Robert-Kurczak/automated-tip-coater-model/BOM.ods

Sheet: Parts list
Module | Part name | Part type | Notes
base | base-top | External-custom | 260x180mm plane, custom cutout
base | base-left-side | External-custom | 60x180mm plane, custom cutout
base | base-right-side | External-custom | 60x180mm plane, custom cutout
base | v-slot-2060x250mm | External
base | v-slot-2060x250mm | External
base | v-slot-2020x250mm | External
base | v-slot-2020x250mm | External
base | v-slot-l-bracket-triple | External
base | v-slot-l-bracket-triple | External
base | v-slot-l-bracket-triple | External
base | v-slot-l-bracket-triple | External
base | 17hs4023-stepper-motor | External
base | gt2-5mm-16t-belt-gear | External
base | base-bottom | External-custom | 260x180mm plane, custom cutout
heater-module | heater-module-base | 3D Print
heater-module | heater-module-8mm-linear-shaft | External-custom | 72mm length
heater-module | heater-module-8mm-linear-shaft | External-custom | 72mm length
heater-module | heater-module-tray-carriage | 3D Print
heater-module | heater-module-tray-carriage-cap | 3D Print
heater-module | lm8uu-linear-bearing | External
heater-module | lm8uu-linear-bearing | External
heater-module | wk1-01-limit-switch | External
heater-module | wk1-01-limit-switch | External
heater-module | heater-module-tray-cap | 3D Print
heater-module | heater-module-tray-carriage-belt-cap | 3D Print
heater-module | heater-module-lw980-heater-tray | External-custom | CNC
heater-module | ceramic-tape-insert-40x2mm | External
heater-module | lw980-ceramic-heater | External
heater-module | heater-module-mounting | 3D Print
heater-module | gt2-5mm-bearing | External
heater-module | gt2-5mm-bearing | External
rotation-module | rotation-module-mounting | 3D Print
rotation-module | rotation-module-mounting-bracket | 3D Print
rotation-module | pololu-3042-dc-motor | External
rotation-module | bd-microlance-3-26g-needle | External-custom | 7mm needle length
x-axis | x-axis-motor-mounting | 3D Print
x-axis | x-axis-end | 3D Print
x-axis | x-axis-carriage | 3D Print
x-axis | x-axis-carriage-cap | 3D Print
x-axis | lm8uu-linear-bearing | External
x-axis | gt2-5mm-bearing | External
x-axis | lm8uu-linear-bearing | External
x-axis | 17hs4023-stepper-motor | External
x-axis | gt2-5mm-16t-belt-gear | External
x-axis | wk1-01-limit-switch | External
x-axis | wk1-01-limit-switch | External
x-axis | x-axis-8mm-linear-shaft | External-custom | 200mm length
x-axis | x-axis-8mm-linear-shaft | External-custom | 200mm length
z-axis | z-axis-shafts-mounting | 3D Print
z-axis | 17hs8401-stepper-motor | External
z-axis | z-axis-8mm-linear-shaft | External-custom | 197mm length
z-axis | z-axis-8mm-linear-shaft | External-custom | 197mm length
z-axis | 5x8mm-flexible-coupler | External
z-axis | z-axis-tr8x2-lead-screw | External-custom | 113mm length
z-axis | lm8uu-45mm-linear-bearing | External
z-axis | lm8uu-45mm-linear-bearing | External
z-axis | z-axis-carriage | 3D Print
z-axis | z-axis-carriage-bearing-cap | 3D Print
z-axis | z-axis-carriage-bearing-cap | 3D Print

Sheet: External
Part name | Notes | Amount | Link | Price per item [PLN] | Price [PLN] | Total price [PLN]
v-slot-2060x250mm |  | 2 | v-slot.pl (https://www.v-slot.pl/pl/p/V-SLOT-2060-Czarny-Anodowany-250mm/54) | 20.00 | 40.00 | 431.28
v-slot-2020x250mm |  | 2 | v-slot.pl (https://www.v-slot.pl/pl/p/Profil-aluminiowy-konstrukcyjny-V-Slot-2020-Na-wymiar-BLACK/906) | 12.00 | 24.00
v-slot-l-bracket-triple |  | 4 | v-slot.pl (https://www.v-slot.pl/pl/p/Naroznik-typ-L-potrojny-OpenBuilds/224) | 6.99 | 27.96
17hs4023-stepper-motor |  | 2 | allegro.pl-Fotobisti_pl (https://allegro.pl/oferta/silnik-krokowy-nema17-17hs4023-pancake-23mm-118g-16010231320) | 35.85 | 71.70
gt2-5mm-16t-belt-gear |  | 2 | abc-rc.pl (https://abc-rc.pl/pl/products/zebatka-gt2-16-zebow-5mm-drukarka-3d-reprap-3d-cnc-6732.html) | 3.10 | 6.20
lm8uu-linear-bearing |  | 4 | abc-rc.pl (https://abc-rc.pl/pl/products/lozysko-liniowe-lm8uu-8mm-reprap-3d-cnc-6735.html) | 3.00 | 12.00
wk1-01-limit-switch |  | 4 | abc-rc.pl (https://abc-rc.pl/pl/products/wylacznik-krancowy-wk1-01-1a-125v-przelacznik-przyciskowy-20701.html) | 0.90 | 3.60
ceramic-tape-insert-40x2mm |  | 1 | allegro.pl-Bomawit (https://allegro.pl/oferta/tasma-ceramiczna-zaroodporna-1200-c-do-kominka-40x2-mm-5859353940) | 17.60 | 17.60
lw980-ceramic-heater |  | 1 | allegro.pl-GOTRONIK_PL (https://allegro.pl/oferta/grzalka-ceramiczna-do-lw-980d-lut-036-7519979241) | 26.56 | 26.56
gt2-5mm-bearing |  | 3 | abc-rc.pl (https://abc-rc.pl/pl/products/kolo-pasowe-gt2-bez-zebow-czarne-os-5mm-na-pasek-6mm-drukarka-3d-reprap-3d-cnc-20537.html) | 6.20 | 18.60
pololu-3042-dc-motor |  | 1 | ebmia.pl (https://www.ebmia.pl/silniki-dc-z-przekladnia/217056-silnik-hpcb-150-1-12v-200rpm-zamiennik-pololu-3042.html) | 35.60 | 35.60
17hs8401-stepper-motor |  | 1 | allegro.pl-100hz_pl (https://allegro.pl/oferta/silnik-krokowy-do-drukarki-17hs8401-kabel-15601388050) | 48.50 | 48.50
5x8mm-flexible-coupler |  | 1 | abc-rc.pl (https://abc-rc.pl/pl/products/sprzeglo-elastyczne-5-8-mm-sprzeglo-aluminiowe-do-drukarki-3d-6460.html) | 5.80 | 5.80
lm8uu-45mm-linear-bearing |  | 2 | abc-rc.pl (https://abc-rc.pl/pl/products/lozysko-liniowe-lm8uu-8mm-45mm-dl-reprap-3d-cnc-9713.html) | 8.40 | 16.80
Custom parts | #N/A | 0 |  |  | 0.00
heater-module-8mm-linear-shaft | 72mm length | 2 | v-slot.pl (https://www.v-slot.pl/walek-liniowy-prowadnica-fi-8mm) | 35.00 | 35.00
x-axis-8mm-linear-shaft | 200mm length | 2
z-axis-8mm-linear-shaft | 197mm length | 2
base-top | 260x180mm plane, custom cutout | 1 | allegro.pl-Betulla_com_pl (https://allegro.pl/oferta/sklejka-5mm-formatka-600x400mm-klasa-2-do-lasera-8141591806) | 15.20 | 15.20
base-left-side | 60x180mm plane, custom cutout | 1
base-right-side | 60x180mm plane, custom cutout | 1
base-bottom | 260x180mm plane, custom cutout | 1
heater-module-lw980-heater-tray | CNC | 1
bd-microlance-3-26g-needle | 7mm needle length | 1 | medimall.pl (https://medimall.pl/Igly-iniekcyjne-BD-MICROLANCE-045x13-26G-303800-100-sz) | 0.11 | 0.11
z-axis-tr8x2-lead-screw | 113mm length | 1 | allegro.pl-wizjerMP (https://allegro.pl/oferta/sruba-trapezowa-tr8x2-300mm-nakretka-16298195628) | 26.05 | 26.05

Sheet: Parts
Name | Type | Notes | Quantity | Purchase link | Purchase price [PLN] | Purchase quantity | Total price [PLN]
heater-module-base | 3D Print |  | 1 | allegro-sklep_X3D (https://allegro.pl/oferta/filament-fiberlogy-easy-pla-alien-green-zielony-brokatowy-1-75-0-85kg-14364995352) | 88.40 | 1 | 88.40
heater-module-cap | 3D Print |  | 1 | allegro-sklep_X3D (https://allegro.pl/oferta/filament-fiberlogy-easy-pla-black-czarny-1-75mm-0-85kg-10711424223) | 79.10 | 1 | 79.10
heater-module-mounting | 3D Print |  | 1 |  |  |  | 0.00
heater-module-tray-cap | 3D Print |  | 1 |  |  |  | 0.00
heater-module-tray-carriage | 3D Print |  | 1 |  |  |  | 0.00
heater-module-tray-carriage-belt-cap | 3D Print |  | 1 |  |  |  | 0.00
heater-module-tray-carriage-cap | 3D Print |  | 1 |  |  |  | 0.00
rotation-module-mounting | 3D Print |  | 1 |  |  |  | 0.00
rotation-module-mounting-bracket | 3D Print |  | 1 |  |  |  | 0.00
x-axis-carriage | 3D Print |  | 1 |  |  |  | 0.00
x-axis-carriage-cap | 3D Print |  | 1 |  |  |  | 0.00
x-axis-end | 3D Print |  | 1 |  |  |  | 0.00
x-axis-motor-mounting | 3D Print |  | 1 |  |  |  | 0.00
z-axis-carriage | 3D Print |  | 1 |  |  |  | 0.00
z-axis-carriage-bearing-cap | 3D Print |  | 2 |  |  |  | 0.00
z-axis-shafts-mounting | 3D Print |  | 1 |  |  |  | 0.00
10x2mm-magnet | External |  | 4 | abc-rc.pl (https://abc-rc.pl/pl/products/magnes-10x2mm-walcowy-n38-neodymowy-6778.html) | 1.20 | 4 | 4.80
17hs4023-stepper-motor | External |  | 2 | allegro.pl-Fotobisti_pl (https://allegro.pl/oferta/silnik-krokowy-nema17-17hs4023-pancake-23mm-118g-16010231320) | 35.85 | 2 | 71.70
17hs8401-stepper-motor | External |  | 1 | allegro.pl-100hz_pl (https://allegro.pl/oferta/silnik-krokowy-do-drukarki-17hs8401-kabel-15601388050) | 48.50 | 1 | 48.50
5x8mm-flexible-coupler | External |  | 1 | abc-rc.pl (https://abc-rc.pl/pl/products/sprzeglo-elastyczne-5-8-mm-sprzeglo-aluminiowe-do-drukarki-3d-6460.html) | 5.80 | 1 | 5.80
bd-microlance-3-26g-needle | External | 7mm needle length | 1 | medimall.pl (https://medimall.pl/Igly-iniekcyjne-BD-MICROLANCE-045x13-26G-303800-100-sz) | 10.85 | 1 | 10.85
ceramic-tape-insert-40x2mm | External |  | 1 | allegro.pl-Bomawit (https://allegro.pl/oferta/tasma-ceramiczna-zaroodporna-1200-c-do-kominka-40x2-mm-5859353940) | 17.60 | 1 | 17.60
gt2-20t-5mm-driver-pulley | External |  | 2 | abc-rc.pl (https://abc-rc.pl/pl/products/zebatka-gt2-20-zebow-5mm-drukarka-3d-reprap-3d-cnc-6731.html) | 3.60 | 2 | 7.20
gt2-20t-5mm-idle-pulley | External |  | 3 | abc-rc.pl (https://abc-rc.pl/pl/products/zebatka-gt2-20-zebow-os-5mm-na-pasek-6mm-drukarka-3d-reprap-3d-cnc-9740.html) | 5.90 | 3 | 17.70
gt2-brass-clip | External |  | 4 | allegro-4Makers_pl (https://allegro.pl/oferta/2x-zakowka-zacisk-paska-gt2-6mm-koncowka-zakonczenie-klips-spinka-2-szt-15160004280) | 2.99 | 2 | 5.98
lm8uu-45mm-linear-bearing | External |  | 2 | abc-rc.pl (https://abc-rc.pl/pl/products/lozysko-liniowe-lm8uu-8mm-45mm-dl-reprap-3d-cnc-9713.html) | 8.40 | 2 | 16.80
lm8uu-linear-bearing | External |  | 4 | abc-rc.pl (https://abc-rc.pl/pl/products/lozysko-liniowe-lm8uu-8mm-reprap-3d-cnc-6735.html) | 3.00 | 4 | 12.00
lw980-ceramic-heater | External |  | 1 | allegro.pl-GOTRONIK_PL (https://allegro.pl/oferta/grzalka-ceramiczna-do-lw-980d-lut-036-7519979241) | 26.56 | 1 | 26.56
m2-hex-nut | External |  | 15 | allegro-BEJMETnierdzewne (https://allegro.pl/oferta/nakretka-szesciokatna-nierdzewna-din934-m2-40szt-7185634678) | 2.00 | 1 | 2.00
m2x14-cap-screw | External |  | 7 | allegro-BEJMETnierdzewne (https://allegro.pl/oferta/m2x14-sruba-walcowa-nierdzewna-sruby-10szt-8483067198) | 1.10 | 1 | 1.10
m2x20-cap-screw | External |  | 22 | allegro-BEJMETnierdzewne (https://allegro.pl/oferta/m2x20-sruba-walcowa-nierdzewna-sruby-10szt-8483079186) | 1.20 | 3 | 3.60
m3-square-nut | External |  | 26 | allegro-4Makers_pl (https://allegro.pl/oferta/nakretka-kwadratowa-niska-m3-20-szt-din562-ocynk-11751169602) | 3.20 | 2 | 6.40
m3-washer | External |  | 4 | allegro-BEJMETnierdzewne (https://allegro.pl/oferta/m3-podkladka-plaska-nierdzewna-din125-100szt-16794000647) | 1.85 | 1 | 1.85
m3x20-round-screw | External |  | 2 | allegro-BEJMETnierdzewne (https://allegro.pl/oferta/m3x20-sruba-kulista-nierdzewna-na-imbus-sruby-15st-7186647425) | 1.80 | 1 | 1.80
m3x25-countersink-screw | External |  | 14 | allegro-BEJMETnierdzewne (https://allegro.pl/oferta/m3x25-sruba-nierdzewna-imbusowa-stozkowa-12st-8862453728) | 1.20 | 2 | 2.40
m3x25-round-screw | External |  | 6 | allegro-BEJMETnierdzewne (https://allegro.pl/oferta/m3x25-sruba-kulista-nierdzewna-na-imbus-sruby-10st-7186648146) | 1.29 | 1 | 1.29
m3x30-countersink-screw | External |  | 16 | allegro-BEJMETnierdzewne (https://allegro.pl/oferta/m3x30-sruba-nierdzewna-imbusowa-stozkowa-12s-knaga-8934069624) | 1.20 | 2 | 2.40
m3x40-countersink-screw | External |  | 4 | allegro-BEJMETnierdzewne (https://allegro.pl/oferta/m3x40-sruba-nierdzewna-imbusowa-stozkowa-10s-knaga-8934070901) | 1.99 | 1 | 1.99
m5-square-nut | External |  | 5 | allegro-4Makers_pl (https://allegro.pl/oferta/nakretka-kwadratowa-niska-m5-20-szt-din562-ocynk-11751488499) | 3.60 | 1 | 3.60
m5x10-countersink-screw | External |  | 8 | allegro-BEJMETnierdzewne (https://allegro.pl/oferta/m5x10-sruba-nierdzewna-imbusowa-stozkowa-12st-12593537318) | 1.20 | 1 | 1.20
m5x25-round-screw | External |  | 1 | allegro-BEJMETnierdzewne (https://allegro.pl/oferta/m5x25-sruba-kulista-nierdzewna-na-imbus-wkret-6szt-7187104649) | 1.20 | 1 | 1.20
m5x70-countersink-screw | External |  | 4 | allegro-BEJMETnierdzewne (https://allegro.pl/oferta/m5x70-sruba-nierdzewna-imbusowa-stozkowa-5st-7162775822) | 2.20 | 1 | 2.20
m5x8-round-screw | External |  | 8 | allegro-BEJMETnierdzewne (https://allegro.pl/oferta/m5x8-sruba-kulista-nierdzewna-na-imbus-wkret-10szt-7187097174) | 1.29 | 1 | 1.29
pololu-3042-dc-motor | External |  | 1 | ebmia.pl (https://www.ebmia.pl/silniki-dc-z-przekladnia/217056-silnik-hpcb-150-1-12v-200rpm-zamiennik-pololu-3042.html) | 35.60 | 1 | 35.60
tr8x2-anti-backlash-nut | External |  | 1 | allegro-4Makers_pl (https://allegro.pl/oferta/nakretka-mosiezna-bezluzowa-sruby-trapezowej-tr8x2-11863135709) | 7.99 | 1 | 7.99
v-slot-2020x200mm | External |  | 2 | v-slot.pl (https://www.v-slot.pl/pl/p/Profil-aluminiowy-konstrukcyjny-V-Slot-2020-Na-wymiar-BLACK/906) | 12.00 | 2 | 24.00
v-slot-2060x250mm | External |  | 2 | v-slot.pl (https://www.v-slot.pl/pl/p/V-SLOT-2060-Czarny-Anodowany-250mm/54) | 20.00 | 2 | 40.00
v-slot-5mm-t-nut | External |  | 10 | allegro-4Makers_pl (https://allegro.pl/oferta/nakretka-mloteczkowa-nieobracalna-t-nut-m5-10szt-11858625657) | 7.99 | 1 | 7.99
v-slot-90-deg-bracket | External |  | 4 | v-slot.pl (https://www.v-slot.pl/pl/p/Naroznik-90-stopni-Czarny/215) | 3.90 | 4 | 15.60
wk1-01-limit-switch | External |  | 6 | abc-rc.pl (https://abc-rc.pl/pl/products/wylacznik-krancowy-wk1-01-1a-125v-przelacznik-przyciskowy-20701.html) | 0.90 | 6 | 5.40
base-left-side | External-custom | 60x180mm plane, custom cutout | 1 | allegro.pl-Betulla_com_pl (https://allegro.pl/oferta/sklejka-5mm-formatka-600x400mm-klasa-2-do-lasera-8141591806) | 16.40 | 1 | 16.40
base-right-side | External-custom | 60x180mm plane, custom cutout | 1 |  |  |  | 0.00
base-top | External-custom | 260x180mm plane, custom cutout | 1 |  |  |  | 0.00
heater-module-8mm-linear-shaft | External-custom | 72mm length | 2 | v-slot.pl (https://www.v-slot.pl/walek-liniowy-prowadnica-fi-8mm) | 35.00 | 1 | 35.00
heater-module-gt2-timing-belt | External-custom |  | 1 | allegro-4Makers_pl (https://allegro.pl/oferta/pasek-zebaty-gt2-6mm-stalowy-rdzen-1m-11895522099) | 5.80 | 1 | 5.80
heater-module-lw980-heater-tray | External-custom | CNC | 1 |  |  |  | 0.00
x-axis-8mm-linear-shaft | External-custom | 200mm length | 2 | Cut from heater-module-8mm-linear-shaft |  |  | 0.00
x-axis-gt2-timing-belt | External-custom |  | 1 | Cut from heater-module-gt2-timing-belt |  |  | 0.00
z-axis-8mm-linear-shaft | External-custom | 207mm length | 2 | Cut from heater-module-8mm-linear-shaft |  |  | 0.00
z-axis-tr8x2-lead-screw | External-custom | 123mm length | 1 | allegro.pl-wizjerMP (https://allegro.pl/oferta/sruba-trapezowa-tr8x2-300mm-nakretka-16298195628) | 26.05 | 1 | 26.05

Sheet: Needed
Name | Type | Notes | Quantity | Purchase link | Purchase price [PLN] | Purchase quantity | z
heater-module-base | 3D Print |  | 1 | allegro-sklep_X3D (https://allegro.pl/oferta/filament-fiberlogy-easy-pla-alien-green-zielony-brokatowy-1-75-0-85kg-14364995352) | 88.40 | 1 | 88.40
heater-module-cap | 3D Print |  | 1 | allegro-sklep_X3D (https://allegro.pl/oferta/filament-fiberlogy-easy-pla-black-czarny-1-75mm-0-85kg-10711424223) | 79.10 | 1 | 79.10
17hs4023-stepper-motor | External |  | 2 | allegro.pl-Fotobisti_pl (https://allegro.pl/oferta/silnik-krokowy-nema17-17hs4023-pancake-23mm-118g-16010231320) | 35.85 | 2 | 71.70
17hs8401-stepper-motor | External |  | 1 | allegro.pl-100hz_pl (https://allegro.pl/oferta/silnik-krokowy-do-drukarki-17hs8401-kabel-15601388050) | 48.50 | 1 | 48.50
5x8mm-flexible-coupler | External |  | 1 | abc-rc.pl (https://abc-rc.pl/pl/products/sprzeglo-elastyczne-5-8-mm-sprzeglo-aluminiowe-do-drukarki-3d-6460.html) | 5.80 | 1 | 5.80
ceramic-tape-insert-40x2mm | External |  | 1 | allegro.pl-Bomawit (https://allegro.pl/oferta/tasma-ceramiczna-zaroodporna-1200-c-do-kominka-40x2-mm-5859353940) | 17.60 | 1 | 17.60
gt2-20t-5mm-driver-pulley | External |  | 2 | abc-rc.pl (https://abc-rc.pl/pl/products/zebatka-gt2-20-zebow-5mm-drukarka-3d-reprap-3d-cnc-6731.html) | 3.60 | 2 | 7.20
gt2-20t-5mm-idle-pulley | External |  | 3 | abc-rc.pl (https://abc-rc.pl/pl/products/zebatka-gt2-20-zebow-os-5mm-na-pasek-6mm-drukarka-3d-reprap-3d-cnc-9740.html) | 5.90 | 3 | 17.70
gt2-brass-clip | External |  | 4 | allegro-4Makers_pl (https://allegro.pl/oferta/2x-zakowka-zacisk-paska-gt2-6mm-koncowka-zakonczenie-klips-spinka-2-szt-15160004280) | 2.99 | 2 | 5.98
lm8uu-45mm-linear-bearing | External |  | 2 | abc-rc.pl (https://abc-rc.pl/pl/products/lozysko-liniowe-lm8uu-8mm-45mm-dl-reprap-3d-cnc-9713.html) | 8.40 | 2 | 16.80
lm8uu-linear-bearing | External |  | 4 | abc-rc.pl (https://abc-rc.pl/pl/products/lozysko-liniowe-lm8uu-8mm-reprap-3d-cnc-6735.html) | 3.00 | 4 | 12.00
lw980-ceramic-heater | External |  | 1 | allegro.pl-GOTRONIK_PL (https://allegro.pl/oferta/grzalka-ceramiczna-do-lw-980d-lut-036-7519979241) | 26.56 | 1 | 26.56
m2x14-cap-screw | External |  | 7 | allegro-BEJMETnierdzewne (https://allegro.pl/oferta/m2x14-sruba-walcowa-nierdzewna-sruby-10szt-8483067198) | 1.10 | 1 | 1.10
m2x20-cap-screw | External |  | 22 | allegro-BEJMETnierdzewne (https://allegro.pl/oferta/m2x20-sruba-walcowa-nierdzewna-sruby-10szt-8483079186) | 1.20 | 3 | 3.60
m3-square-nut | External |  | 26 | allegro-4Makers_pl (https://allegro.pl/oferta/nakretka-kwadratowa-niska-m3-20-szt-din562-ocynk-11751169602) | 3.20 | 2 | 6.40
m3x25-countersink-screw | External |  | 14 | allegro-BEJMETnierdzewne (https://allegro.pl/oferta/m3x25-sruba-nierdzewna-imbusowa-stozkowa-12st-8862453728) | 1.20 | 2 | 2.40
m3x25-round-screw | External |  | 6 | allegro-BEJMETnierdzewne (https://allegro.pl/oferta/m3x25-sruba-kulista-nierdzewna-na-imbus-sruby-10st-7186648146) | 1.29 | 1 | 1.29
m5-square-nut | External |  | 5 | allegro-4Makers_pl (https://allegro.pl/oferta/nakretka-kwadratowa-niska-m5-20-szt-din562-ocynk-11751488499) | 3.60 | 1 | 3.60
m5x25-round-screw | External |  | 1 | allegro-BEJMETnierdzewne (https://allegro.pl/oferta/m5x25-sruba-kulista-nierdzewna-na-imbus-wkret-6szt-7187104649) | 1.20 | 1 | 1.20
m5x70-countersink-screw | External |  | 4 | allegro-BEJMETnierdzewne (https://allegro.pl/oferta/m5x70-sruba-nierdzewna-imbusowa-stozkowa-5st-7162775822) | 2.20 | 1 | 2.20
m5x8-round-screw | External |  | 8 | allegro-BEJMETnierdzewne (https://allegro.pl/oferta/m5x8-sruba-kulista-nierdzewna-na-imbus-wkret-10szt-7187097174) | 1.29 | 1 | 1.29
pololu-3042-dc-motor | External |  | 1 | ebmia.pl (https://www.ebmia.pl/silniki-dc-z-przekladnia/217056-silnik-hpcb-150-1-12v-200rpm-zamiennik-pololu-3042.html) | 35.60 | 1 | 35.60
tr8x2-anti-backlash-nut | External |  | 1 | allegro-4Makers_pl (https://allegro.pl/oferta/nakretka-mosiezna-bezluzowa-sruby-trapezowej-tr8x2-11863135709) | 7.99 | 1 | 7.99
v-slot-90-deg-bracket | External |  | 4 | v-slot.pl (https://www.v-slot.pl/pl/p/Naroznik-90-stopni-Czarny/215) | 3.90 | 4 | 15.60
wk1-01-limit-switch | External |  | 6 | abc-rc.pl (https://abc-rc.pl/pl/products/wylacznik-krancowy-wk1-01-1a-125v-przelacznik-przyciskowy-20701.html) | 0.90 | 6 | 5.40
gt2-tightener | External |  | 2 | abc-rc.pl (https://abc-rc.pl/pl/products/sprezyna-napinacz-paska-ultimaker-2-do-gt2-6mm-drukarka-3d-reprap-7887.html) | 0.37 | 2 | 0.74
heater-module-8mm-linear-shaft | External-custom | 72mm length | 2 | v-slot.pl (https://www.v-slot.pl/walek-liniowy-prowadnica-fi-8mm) | 35.00 | 1 | 35.00
heater-module-gt2-timing-belt | External-custom |  | 1 | allegro-4Makers_pl (https://allegro.pl/oferta/pasek-zebaty-gt2-6mm-stalowy-rdzen-1m-11895522099) | 5.80 | 1 | 5.80
z-axis-tr8x2-lead-screw | External-custom | 123mm length | 1 | allegro.pl-wizjerMP (https://allegro.pl/oferta/sruba-trapezowa-tr8x2-300mm-nakretka-16298195628) | 26.05 | 1 | 26.05
