Robert-Kurczak/automated-tip-coater-model/automated-tip-coater-assembly.FCStd

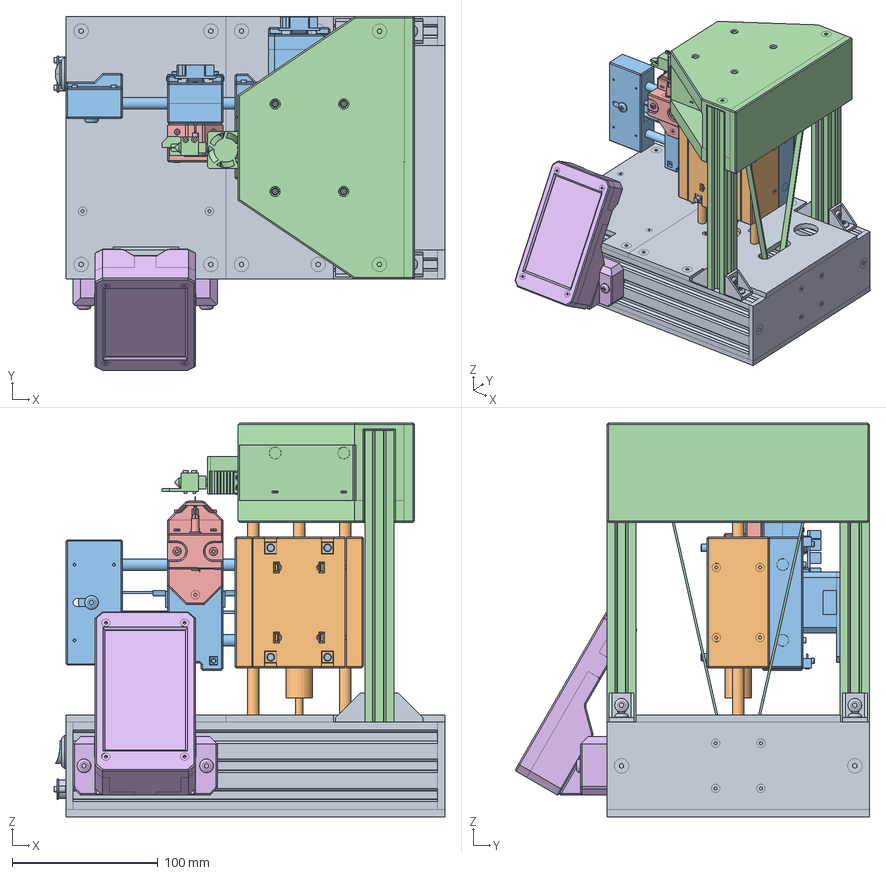
[picture p1: CAD file, 2026-07-16]
automated-tip-coater-assembly.FCStd
268.1 x 242.7 x 270.0 mm
base-assembly_001
z-axis-assembly_001
x-axis-assembly_001
heater-module-assembly_001
rotation-module-assembly_002
display-module-assembly_001
