Robert-Kurczak/automated-tip-coater-model/z-axis/z-axis-assembly.FCStd

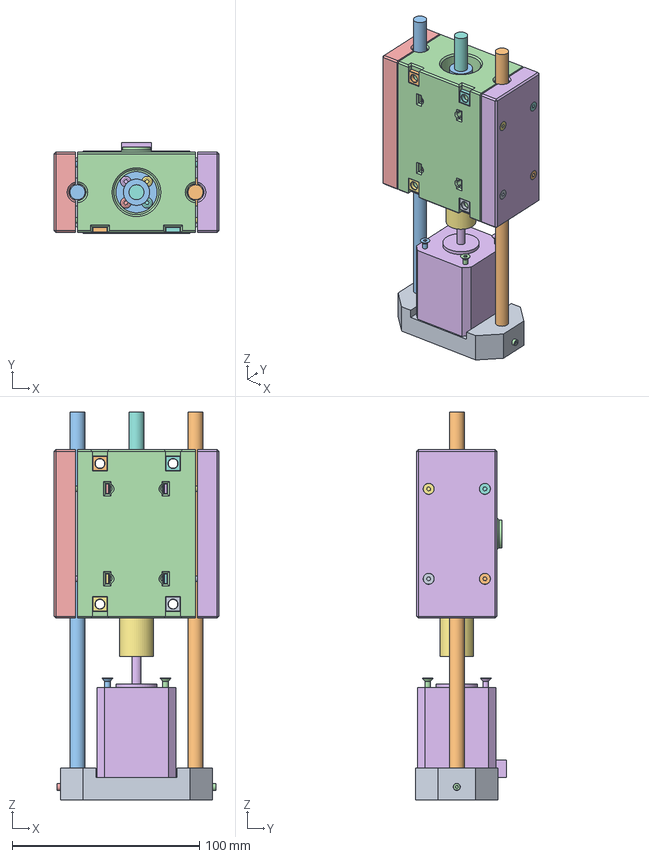
[picture p2: CAD file, 2026-07-16]
z-axis/z-axis-assembly.FCStd
88.0 x 48.5 x 207.0 mm
z-axis-shafts-mounting_001
z-axis-8mm-linear-shaft_001
z-axis-8mm-linear-shaft_002
m2x20-cap-screw_001
m2x20-cap-screw_002
17hs8401-stepper-motor_001
m3x25-countersink-screw_001
m3x25-countersink-screw_002
m3x25-countersink-screw_003
m3x25-countersink-screw_004
m3x25-countersink-screw_005
m3x25-countersink-screw_006
m3x25-countersink-screw_007
m3x25-countersink-screw_008
5x8mm-flexible-coupler_001
z-axis-tr8x2-lead-screw_001
lm8uu-45mm-linear-bearing_001
lm8uu-45mm-linear-bearing_002
tr8x2-anti-backlash-nut_001
z-axis-carriage_001
m3x25-round-screw_001
m3x25-round-screw_002
m3x25-round-screw_003
m3x25-round-screw_004
m3-square-nut_001
m3-square-nut_002
m3-square-nut_003
m3-square-nut_004
m3-square-nut_005
m3-square-nut_006
m3-square-nut_007
m3-square-nut_008
m3-square-nut_009
m3-square-nut_010
m3-square-nut_011
m3-square-nut_012
z-axis-carriage-bearing-cap_001
z-axis-carriage-bearing-cap_002
m3x30-countersink-screw_001
m3x30-countersink-screw_002
m3x30-countersink-screw_003
m3x30-countersink-screw_004
m3x30-countersink-screw_005
m3x30-countersink-screw_006
m3x30-countersink-screw_007
m3x30-countersink-screw_008
m5-square-nut_001
m5-square-nut_002
m5-square-nut_003
m5-square-nut_004
