Robert-Kurczak/automated-tip-coater-model/heater-module/heater-module-custom-tray-assembly.FCStd

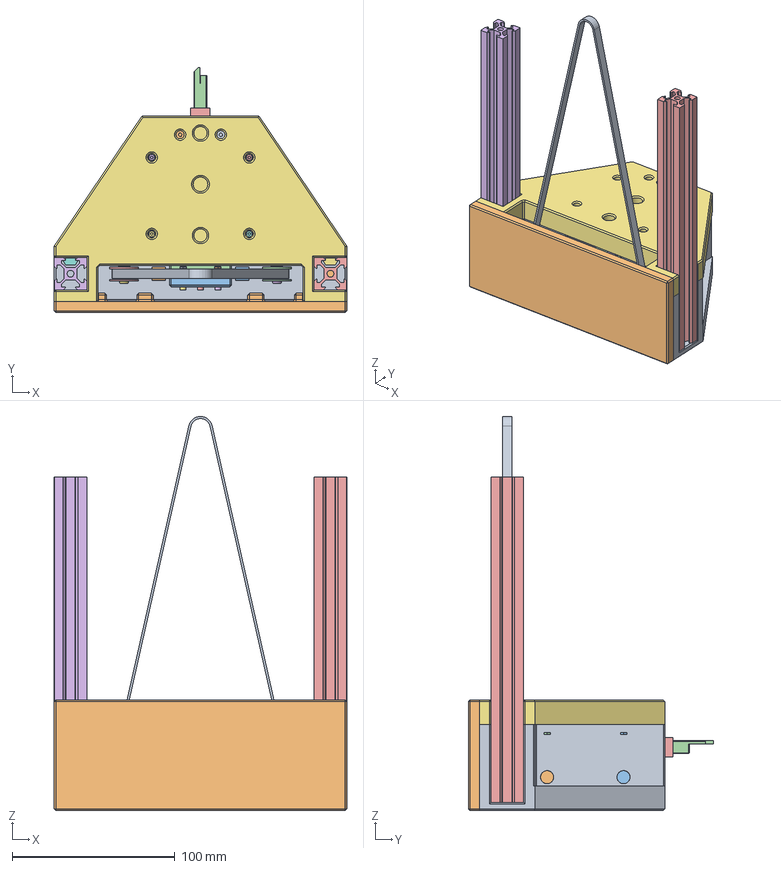
[picture p3: CAD file, 2026-07-16]
heater-module/heater-module-custom-tray-assembly.FCStd
180.0 x 151.0 x 242.3 mm
heater-module-base_001
heater-module-8mm-linear-shaft_001
heater-module-8mm-linear-shaft_002
heater-module-tray-carriage_001
heater-module-tray-carriage-cap_001
lm8uu-linear-bearing_001
lm8uu-linear-bearing_002
wk1-01-limit-switch_001
wk1-01-limit-switch_002
heater-module-tray-cap_001
heater-module-tray-carriage-belt-cap_001
heater-module-lw980-heater-tray_001
ceramic-tape-insert-40x2mm_001
lw980-ceramic-heater_001
heater-module-mounting_001
m3-washer_001
m3-washer_002
m3-washer_003
m3-washer_004
gt2-20t-5mm-idle-pulley_001
gt2-20t-5mm-idle-pulley_002
m3x20-round-screw_001
m3x20-round-screw_002
10x2mm-magnet_001
10x2mm-magnet_002
heater-module-cap_001
10x2mm-magnet_003
10x2mm-magnet_004
m2x14-cap-screw_001
m2x14-cap-screw_002
m2x14-cap-screw_003
m2-hex-nut_001
m2-hex-nut_002
m2-hex-nut_003
m3-square-nut_001
m3-square-nut_002
m3-square-nut_003
m3-square-nut_004
m3x25-countersink-screw_001
m3x25-countersink-screw_002
m3x40-countersink-screw_001
m3x40-countersink-screw_003
m2-hex-nut_004
m2-hex-nut_005
m2-hex-nut_006
m2-hex-nut_007
m2x20-cap-screw_001
m2x20-cap-screw_002
m2x20-cap-screw_003
m2x20-cap-screw_004
m2x20-cap-screw_005
m2x20-cap-screw_006
m2x20-cap-screw_007
m2x20-cap-screw_008
m3-square-nut_005
m3-square-nut_006
m2-hex-nut_008
m2-hex-nut_009
m2-hex-nut_010
m2-hex-nut_011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
