Robert-Kurczak/automated-tip-coater-model/x-axis/x-axis-assembly.FCStd

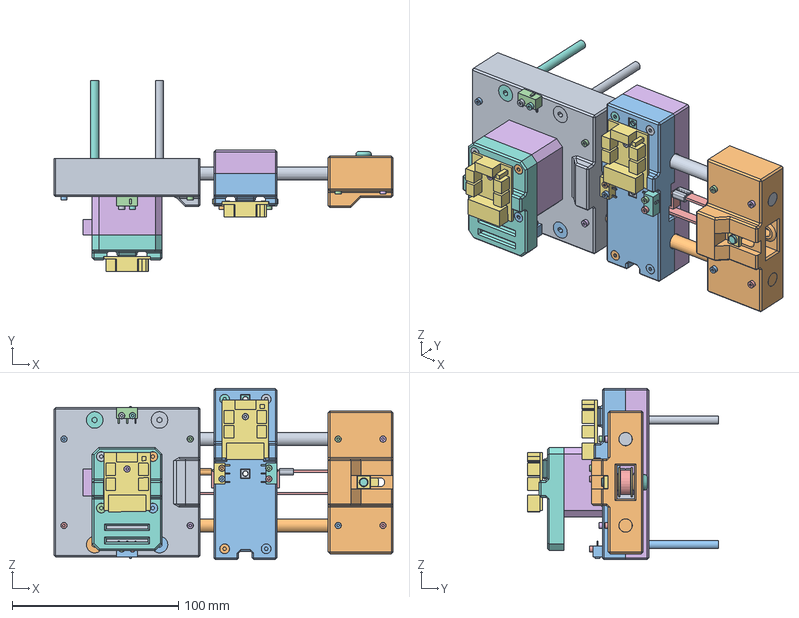
[picture p4: CAD file, 2026-07-16]
x-axis/x-axis-assembly.FCStd
204.0 x 115.1 x 103.0 mm
x-axis-motor-mounting_001
x-axis-end_001
x-axis-carriage-cap_001
lm8uu-linear-bearing_001
lm8uu-linear-bearing_002
17hs4023-stepper-motor_001
wk1-01-limit-switch_001
wk1-01-limit-switch_002
x-axis-8mm-linear-shaft_001
x-axis-8mm-linear-shaft_002
m2x20-cap-screw_001
m2x20-cap-screw_002
m2x20-cap-screw_003
m2x20-cap-screw_004
m3x30-countersink-screw_001
m3x30-countersink-screw_002
m3x30-countersink-screw_003
m3x30-countersink-screw_004
m2x20-cap-screw_005
m2x20-cap-screw_006
m2x20-cap-screw_007
m2x20-cap-screw_008
m5-square-nut_001
m5x70-countersink-screw_001
m5x70-countersink-screw_002
m5x70-countersink-screw_003
m5x70-countersink-screw_004
m2-hex-nut_001
m2-hex-nut_002
m2-hex-nut_003
m2-hex-nut_004
m3x25-countersink-screw_001
m3x25-countersink-screw_002
m3x25-countersink-screw_003
m3x25-countersink-screw_004
m3-square-nut_001
m3-square-nut_002
m3-square-nut_003
m3-square-nut_004
m3-square-nut_005
m3-square-nut_006
m2x14-cap-screw_001
m2x14-cap-screw_002
m2x14-cap-screw_003
m2x14-cap-screw_004
gt2-20t-5mm-driver-pulley_001
gt2-20t-5mm-idle-pulley_001
m5x25-round-screw_002
gt2-brass-clip_001
gt2-brass-clip_002
wk1-01-limit-switch_003
m2x14-cap-screw_005
m2x14-cap-screw_006
m2-hex-nut_005
m2-hex-nut_006
m2x14-cap-screw_007
m2x14-cap-screw_008
m2-hex-nut_007
m2-hex-nut_008
wk1-01-limit-switch_004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
