Robert-Kurczak/automated-tip-coater-model/display-module/display-module-assembly.FCStd

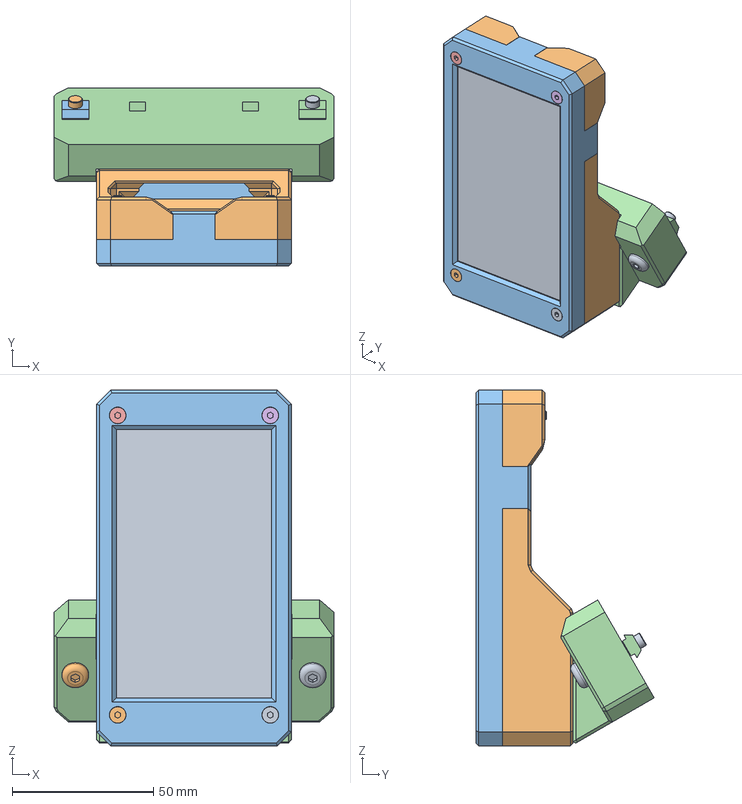
[picture p5: CAD file, 2026-07-16]
display-module/display-module-assembly.FCStd
99.0 x 63.2 x 126.0 mm
waveshare-17143-display_001
display-module-backplate_001
display-module-frontplate_001
m3-square-nut_001
m3-square-nut_002
m3-square-nut_003
m3-square-nut_004
m3x25-countersink-screw_001
m3x30-countersink-screw_001
m3x30-countersink-screw_002
m3x25-countersink-screw_002
display-module-mounting_001
m3x25-countersink-screw_003
m3x25-countersink-screw_004
m3-square-nut_005
m3-square-nut_006
m5x25-round-screw_001
m5x25-round-screw_002
v-slot-5mm-t-nut_001
v-slot-5mm-t-nut_002
