Robert-Kurczak/automated-tip-coater-model/rotation-module/rotation-module-assembly.FCStd

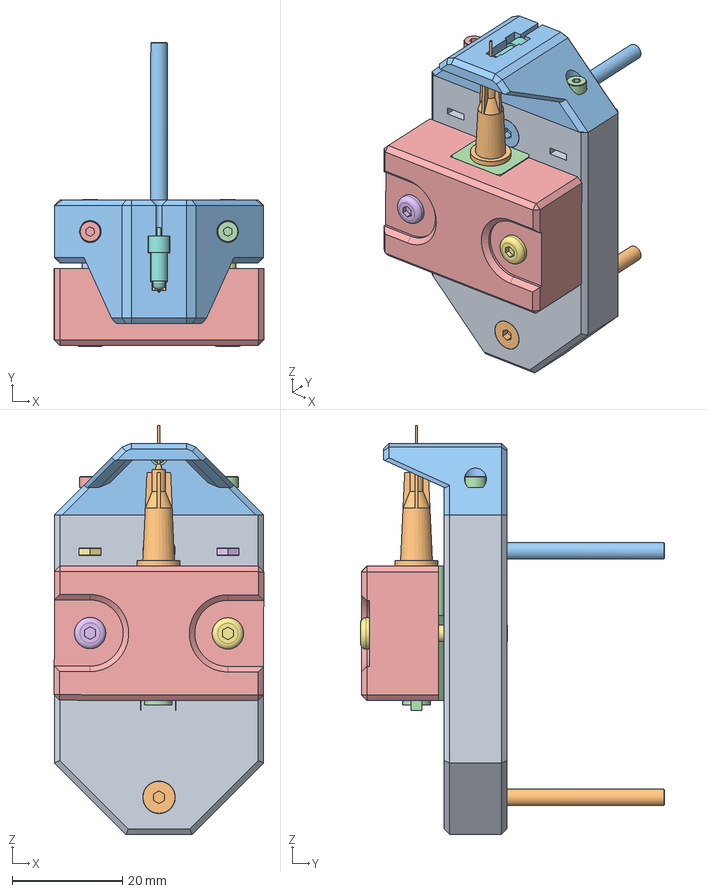
[picture p7: CAD file, 2026-07-16]
rotation-module/rotation-module-assembly.FCStd
38.1 x 55.1 x 74.2 mm
rotation-module-mounting_002
m3x40-countersink-screw_003
m3x40-countersink-screw_004
pololu-3042-dc-motor_002
rotation-module-mounting-bracket_002
m3x25-round-screw_005
m3x25-round-screw_006
m3-square-nut_003
m3-square-nut_004
bd-microlance-3-26g-needle_002
rotation-module-pin-holder_001
m2x14-cap-screw_001
m2x14-cap-screw_002
m2-hex-nut_001
m2-hex-nut_002
09403-pogo-pin_001
