Robert-Kurczak/automated-tip-coater-model/base/base-assembly.FCStd

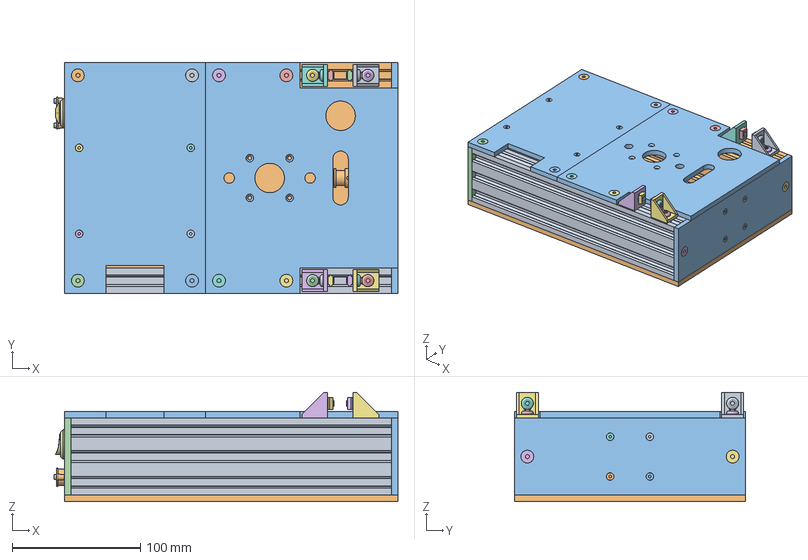
[picture p8: CAD file, 2026-07-16]
base/base-assembly.FCStd
268.1 x 180.0 x 85.0 mm
v-slot-2060x250mm_001
v-slot-2060x250mm_002
base-right-side_001
base-left-side_001
17hs4023-stepper-motor_001
m5x10-countersink-screw_001
m5x10-countersink-screw_002
m3x30-countersink-screw_001
m3x30-countersink-screw_002
m3x30-countersink-screw_003
m3x30-countersink-screw_004
m5x10-countersink-screw_003
m5x10-countersink-screw_004
v-slot-90-deg-bracket_001
v-slot-90-deg-bracket_002
v-slot-90-deg-bracket_003
v-slot-90-deg-bracket_004
v-slot-5mm-t-nut_001
v-slot-5mm-t-nut_002
m5x8-round-screw_001
m5x8-round-screw_002
v-slot-5mm-t-nut_003
v-slot-5mm-t-nut_004
m5x8-round-screw_003
m5x8-round-screw_004
v-slot-5mm-t-nut_005
v-slot-5mm-t-nut_006
v-slot-5mm-t-nut_007
v-slot-5mm-t-nut_008
m5x8-round-screw_005
m5x8-round-screw_006
m5x8-round-screw_007
m5x8-round-screw_008
gt2-20t-5mm-driver-pulley_001
base-electronics-top_001
v-slot-5mm-t-nut_012
v-slot-5mm-t-nut_013
v-slot-5mm-t-nut_014
v-slot-5mm-t-nut_015
v-slot-5mm-t-nut_016
v-slot-5mm-t-nut_017
base-bottom_001
v-slot-5mm-t-nut_018
m5x10-countersink-screw_005
m5x10-countersink-screw_006
v-slot-5mm-t-nut_019
v-slot-5mm-t-nut_020
m5x10-countersink-screw_007
v-slot-5mm-t-nut_021
m5x10-countersink-screw_008
base-motor-top_001
v-slot-5mm-t-nut_022
m5x10-countersink-screw_009
m5x10-countersink-screw_010
m5x10-countersink-screw_011
m5x10-countersink-screw_012
m5x10-countersink-screw_013
m5x10-countersink-screw_014
m5x10-countersink-screw_015
m5x10-countersink-screw_016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
