Robert-Kurczak/automated-tip-coater-model/heater-module/heater-module-bambu-hotend-assembly.FCStd

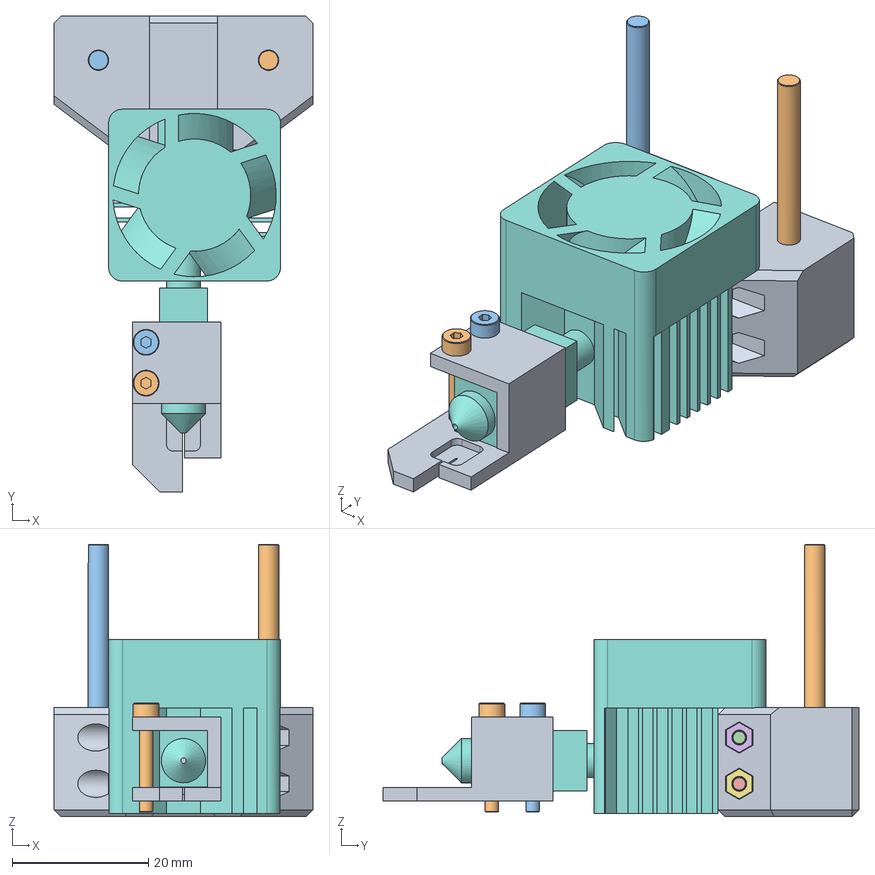
[picture p9: CAD file, 2026-07-16]
heater-module/heater-module-bambu-hotend-assembly.FCStd
38.0 x 70.0 x 40.0 mm
heater-module-hotend-cap_001
m3x40-countersink-screw_001
m3x40-countersink-screw_002
m2x20-cap-screw_001
m2x20-cap-screw_002
m2-hex-nut_001
m2-hex-nut_002
bambu-fah003-hotend_001
heater-module-hotend-tray_001
m2x14-cap-screw_001
m2x14-cap-screw_002
