Robert-Kurczak/automated-tip-coater-model/base/base-electronics-top.FCStd

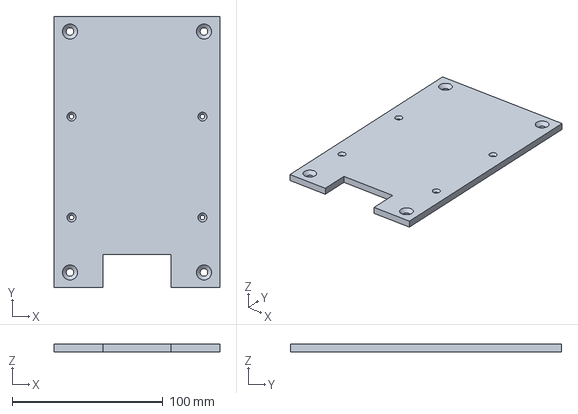
[picture p10: CAD file, 2026-07-16]
base/base-electronics-top.FCStd
110.0 x 180.0 x 5.00 mm
