Robert-Kurczak/automated-tip-coater-model/display-module/display-module-mounting.FCStd

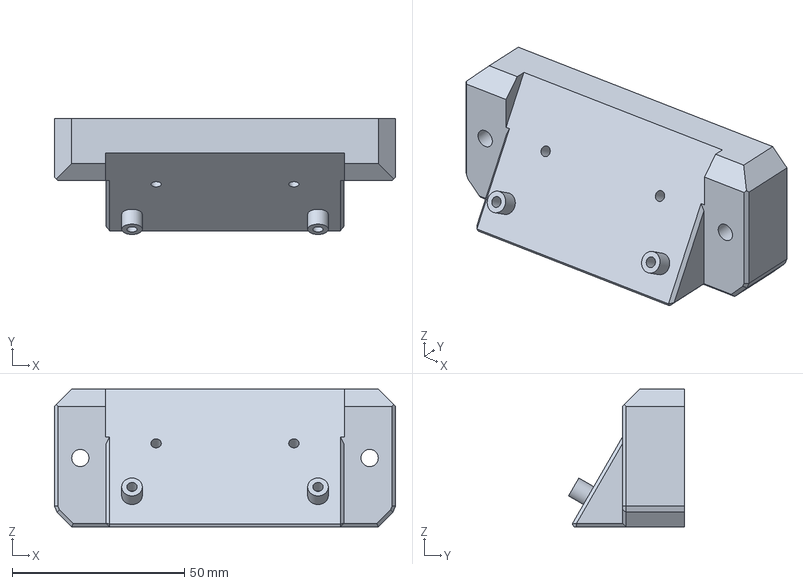
[picture p11: CAD file, 2026-07-16]
display-module/display-module-mounting.FCStd
99.0 x 33.7 x 40.0 mm
