Robert-Kurczak/automated-tip-coater-model/external-parts/wk1-01-limit-switch.FCStd

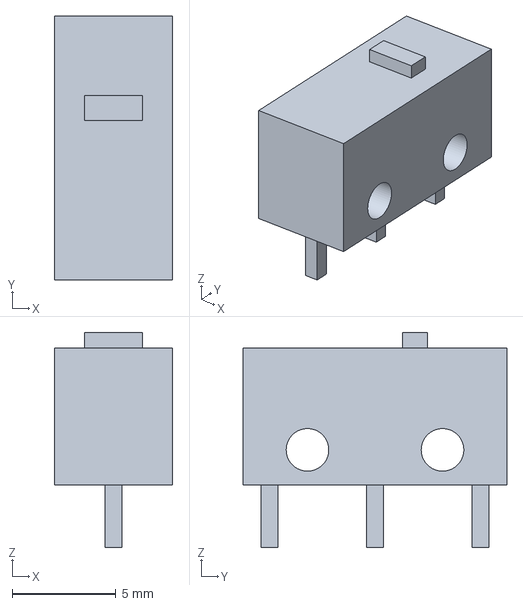
[picture p12: CAD file, 2026-07-16]
external-parts/wk1-01-limit-switch.FCStd
5.70 x 12.7 x 10.3 mm
