Robert-Kurczak/automated-tip-coater-model/heater-module/heater-module-hotend-cap.FCStd

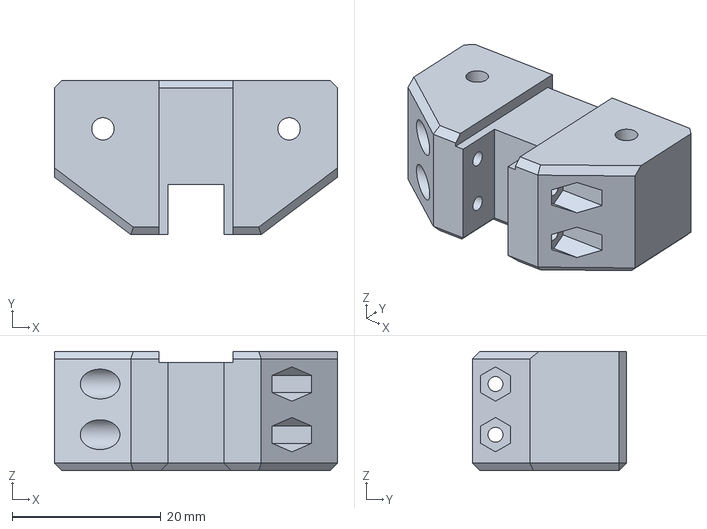
[picture p13: CAD file, 2026-07-16]
heater-module/heater-module-hotend-cap.FCStd
38.0 x 20.7 x 16.0 mm
