Robert-Kurczak/automated-tip-coater-model/rotation-module/rotation-module-mounting.FCStd

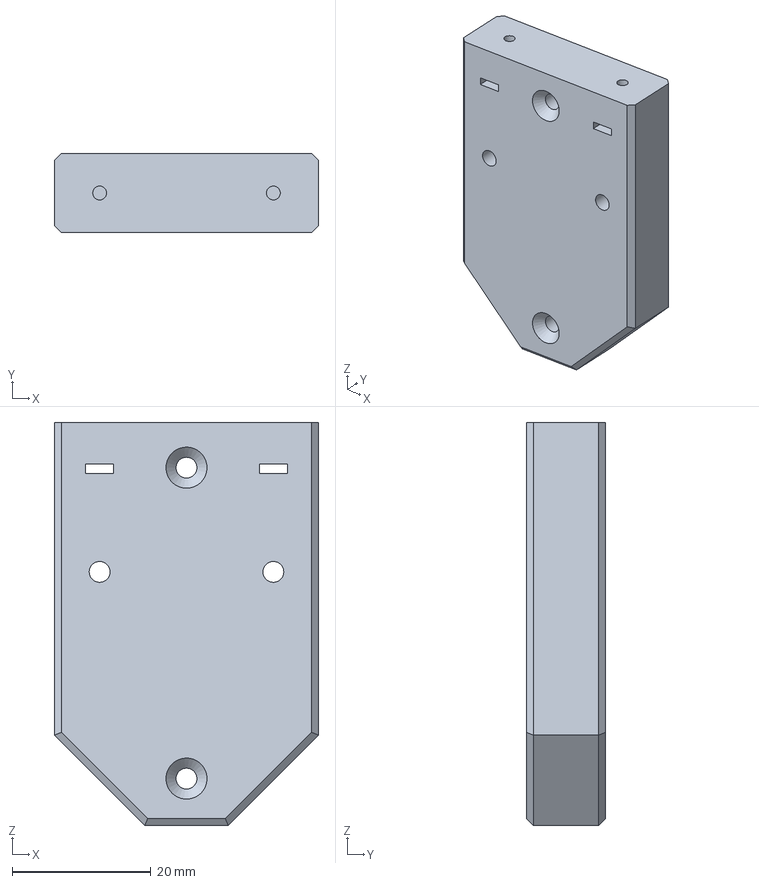
[picture p14: CAD file, 2026-07-16]
rotation-module/rotation-module-mounting.FCStd
38.0 x 11.4 x 58.0 mm
