Robert-Kurczak/automated-tip-coater-model/x-axis/x-axis-gt2-timing-belt.FCStd

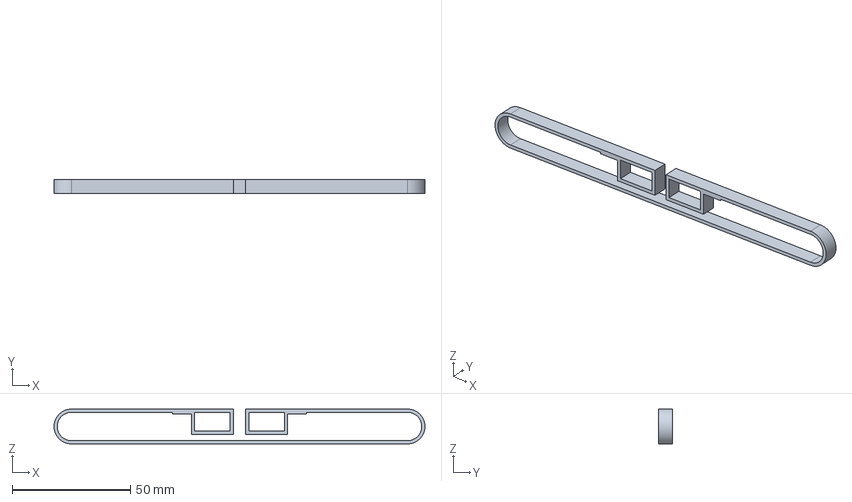
[picture p15: CAD file, 2026-07-16]
x-axis/x-axis-gt2-timing-belt.FCStd
157.1 x 6.00 x 14.8 mm
