Robert-Kurczak/automated-tip-coater-model/base/base-left-side.FCStd

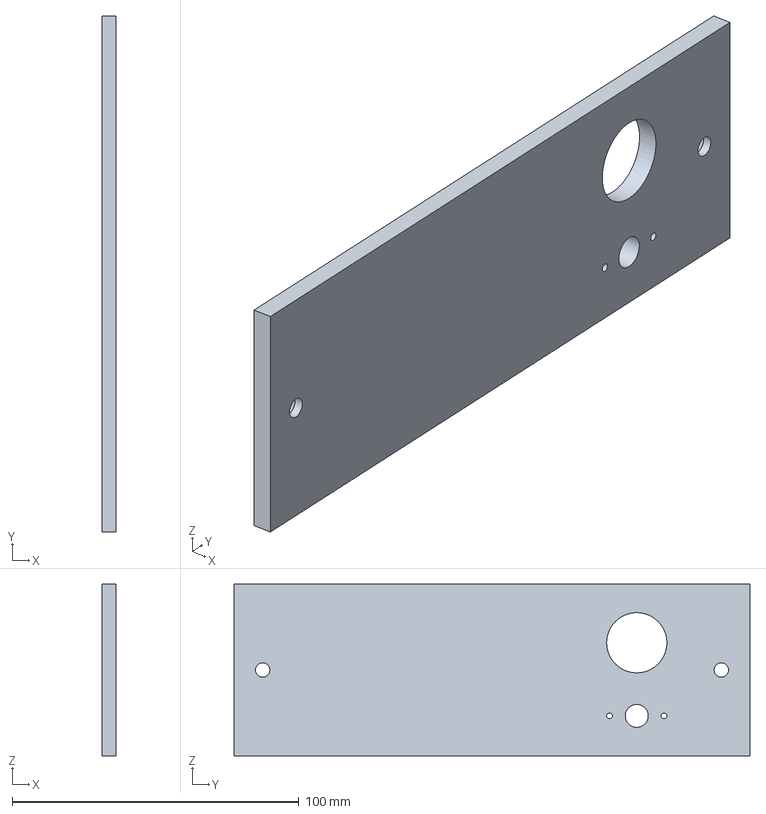
[picture p16: CAD file, 2026-07-16]
base/base-left-side.FCStd
5.00 x 180.0 x 60.0 mm
