Robert-Kurczak/automated-tip-coater-model/display-module/display-module-backplate.FCStd

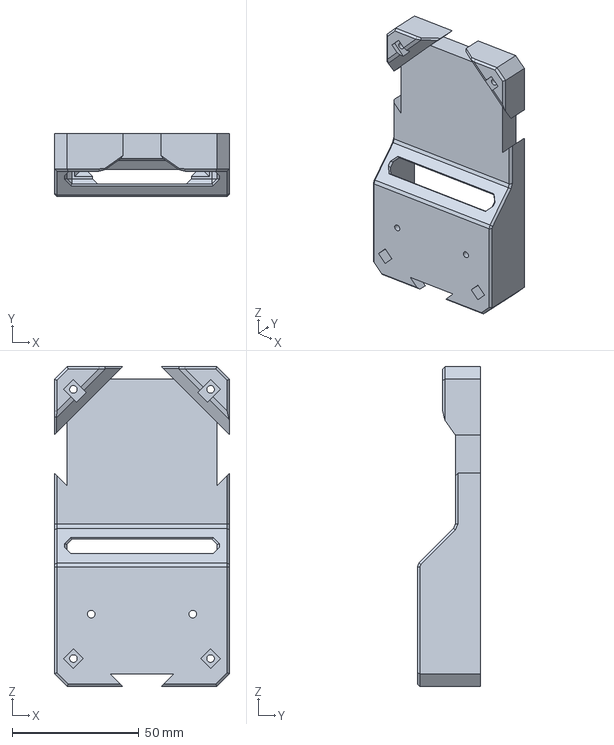
[picture p17: CAD file, 2026-07-16]
display-module/display-module-backplate.FCStd
69.0 x 25.0 x 126.0 mm
