Robert-Kurczak/automated-tip-coater-model/external-parts/waveshare-17143-display.FCStd

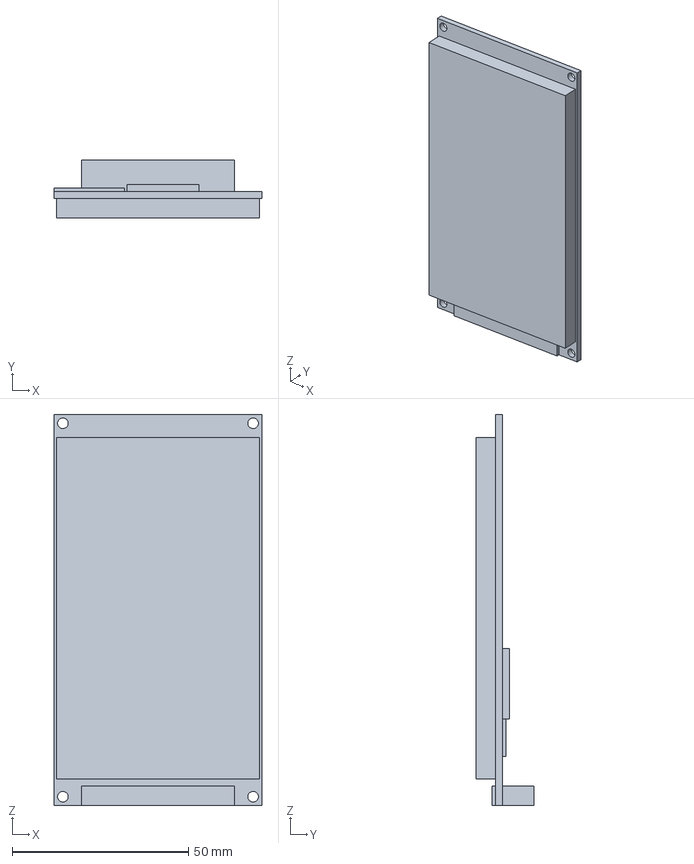
[picture p18: CAD file, 2026-07-16]
external-parts/waveshare-17143-display.FCStd
59.0 x 16.5 x 111.0 mm
