Robert-Kurczak/automated-tip-coater-model/rotation-module/rotation-module-pin-holder.FCStd

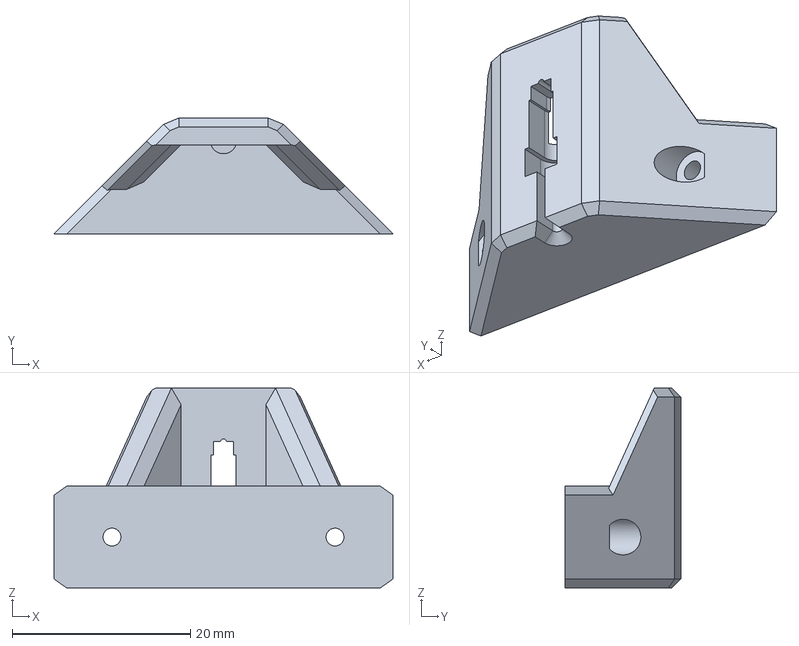
[picture p19: CAD file, 2026-07-16]
rotation-module/rotation-module-pin-holder.FCStd
38.0 x 13.0 x 22.4 mm
