Robert-Kurczak/automated-tip-coater-model/z-axis/z-axis-shafts-mounting.FCStd

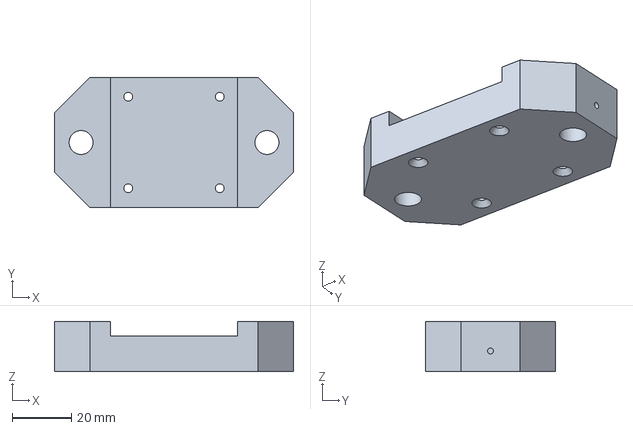
[picture p20: CAD file, 2026-06-24]
z-axis/z-axis-shafts-mounting.FCStd
81.0 x 44.0 x 17.0 mm
