Robert-Kurczak/automated-tip-coater-model/base/base-bottom.FCStd

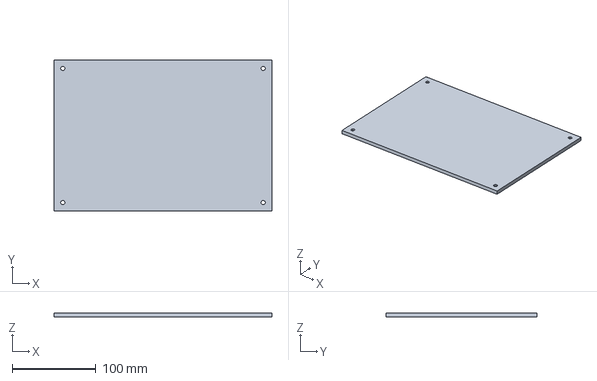
[picture p21: CAD file, 2026-07-16]
base/base-bottom.FCStd
260.0 x 180.0 x 5.00 mm
