Robert-Kurczak/automated-tip-coater-model/heater-module/heater-module-mounting.FCStd

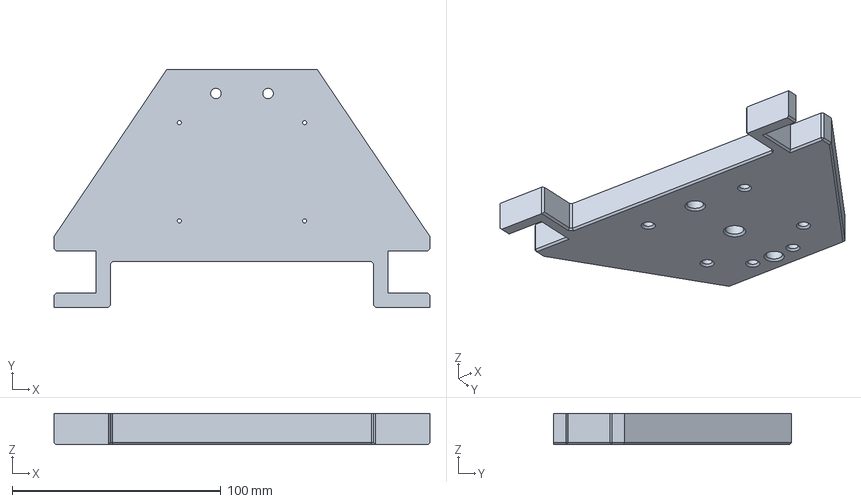
[picture p22: CAD file, 2026-07-16]
heater-module/heater-module-mounting.FCStd
180.0 x 114.0 x 15.0 mm
