Robert-Kurczak/automated-tip-coater-model/rotation-module/rotation-module-shaft-adapter.FCStd

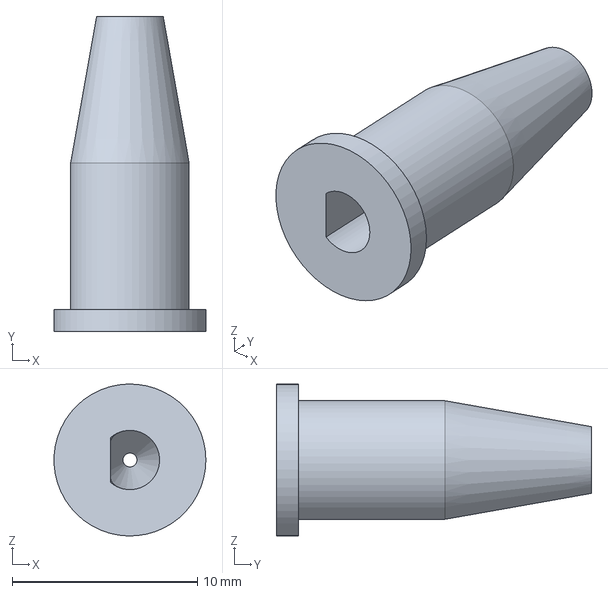
[picture p23: CAD file, 2026-07-16]
rotation-module/rotation-module-shaft-adapter.FCStd
8.19 x 17.0 x 8.20 mm
