Robert-Kurczak/automated-tip-coater-model/x-axis/x-axis-end.FCStd

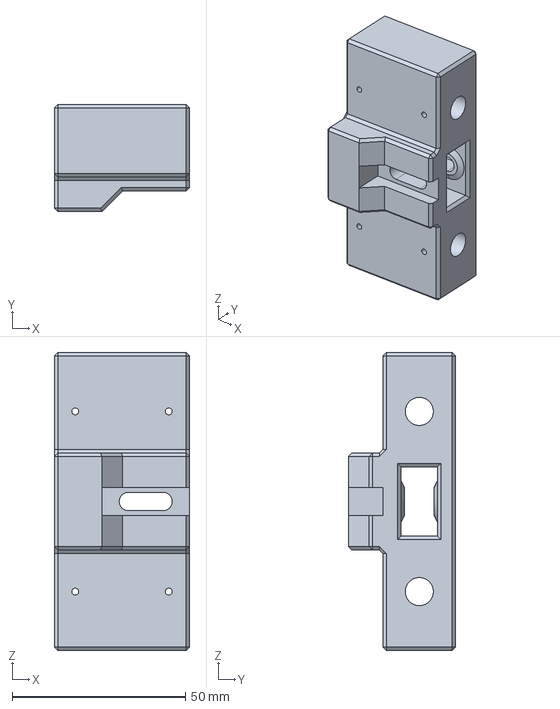
[picture p24: CAD file, 2026-07-16]
x-axis/x-axis-end.FCStd
39.0 x 31.0 x 86.0 mm
