Robert-Kurczak/automated-tip-coater-model/base/base-motor-top.FCStd

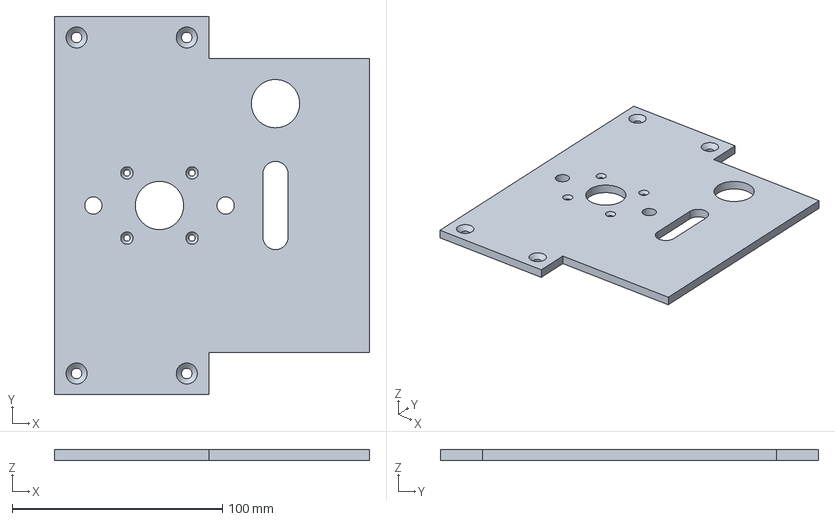
[picture p25: CAD file, 2026-07-16]
base/base-motor-top.FCStd
150.0 x 180.0 x 5.00 mm
