Robert-Kurczak/automated-tip-coater-model/display-module/display-module-frontplate.FCStd

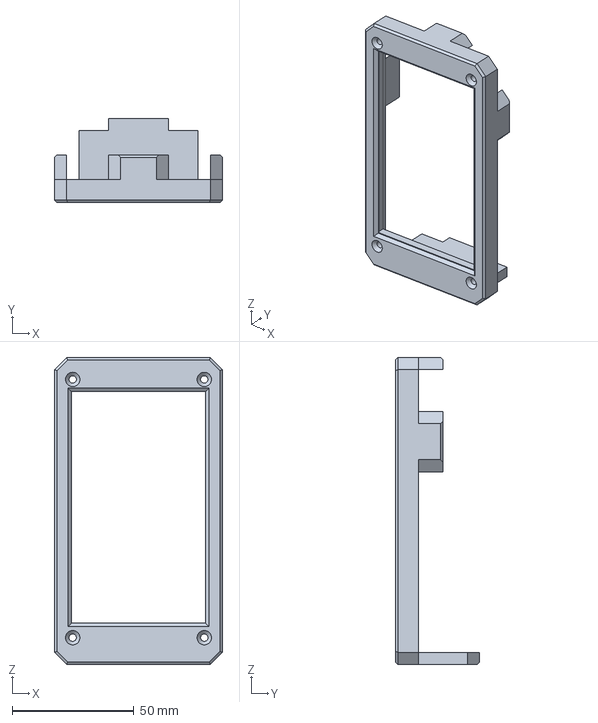
[picture p26: CAD file, 2026-07-16]
display-module/display-module-frontplate.FCStd
69.0 x 34.5 x 126.0 mm
