Robert-Kurczak/automated-tip-coater-model/external-parts/bambu-fah003-hotend.FCStd

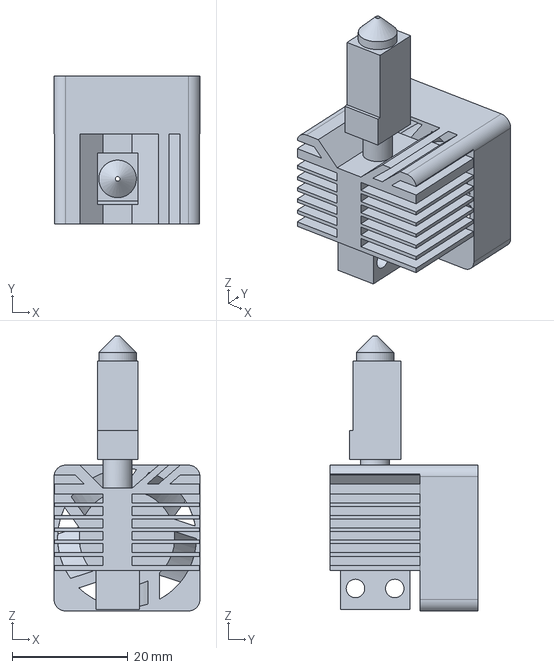
[picture p27: CAD file, 2026-07-16]
external-parts/bambu-fah003-hotend.FCStd
25.2 x 25.6 x 47.6 mm
