Robert-Kurczak/automated-tip-coater-model/x-axis/x-axis-8mm-linear-shaft.FCStd

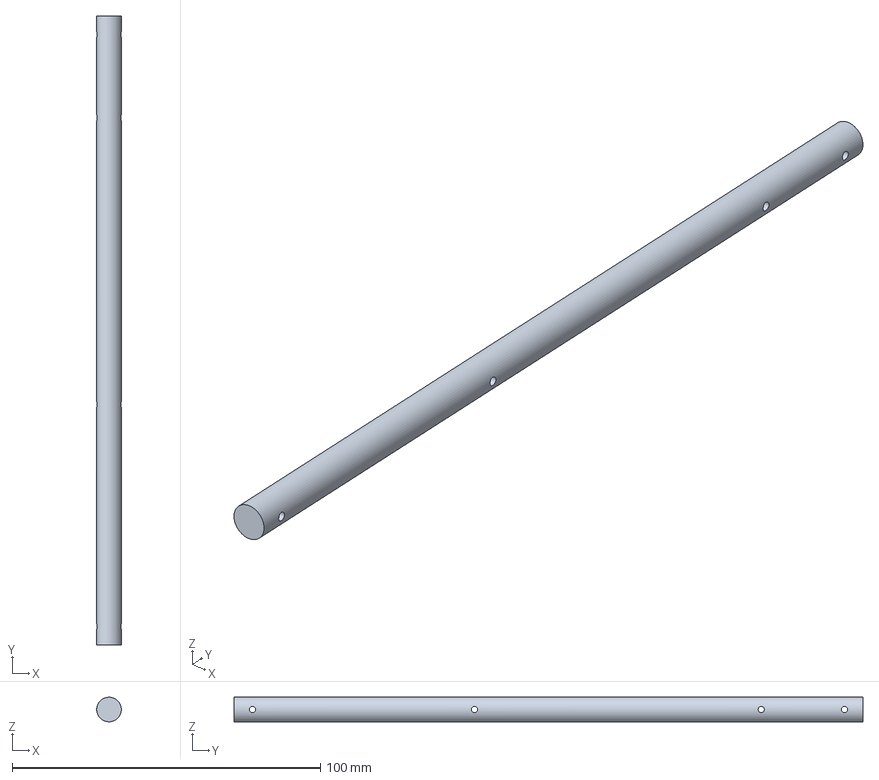
[picture p28: CAD file, 2026-07-16]
x-axis/x-axis-8mm-linear-shaft.FCStd
8.00 x 204.0 x 8.00 mm
