Robert-Kurczak/automated-tip-coater-model/z-axis/z-axis-carriage.FCStd

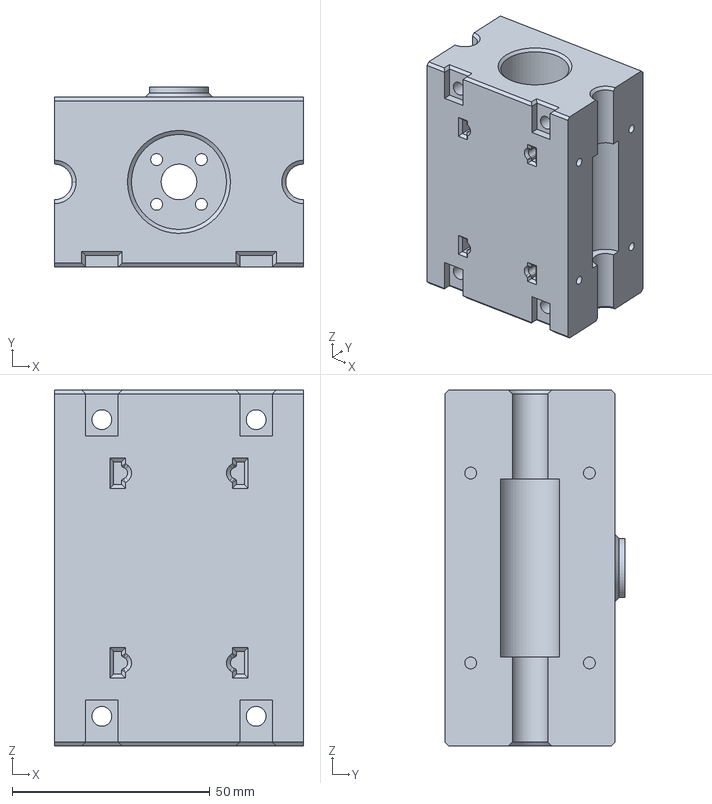
[picture p29: CAD file, 2026-06-24]
z-axis/z-axis-carriage.FCStd
63.0 x 45.5 x 90.0 mm
