Robert-Kurczak/automated-tip-coater-model/external-parts/kpjx-pm-4s-power-connector.FCStd

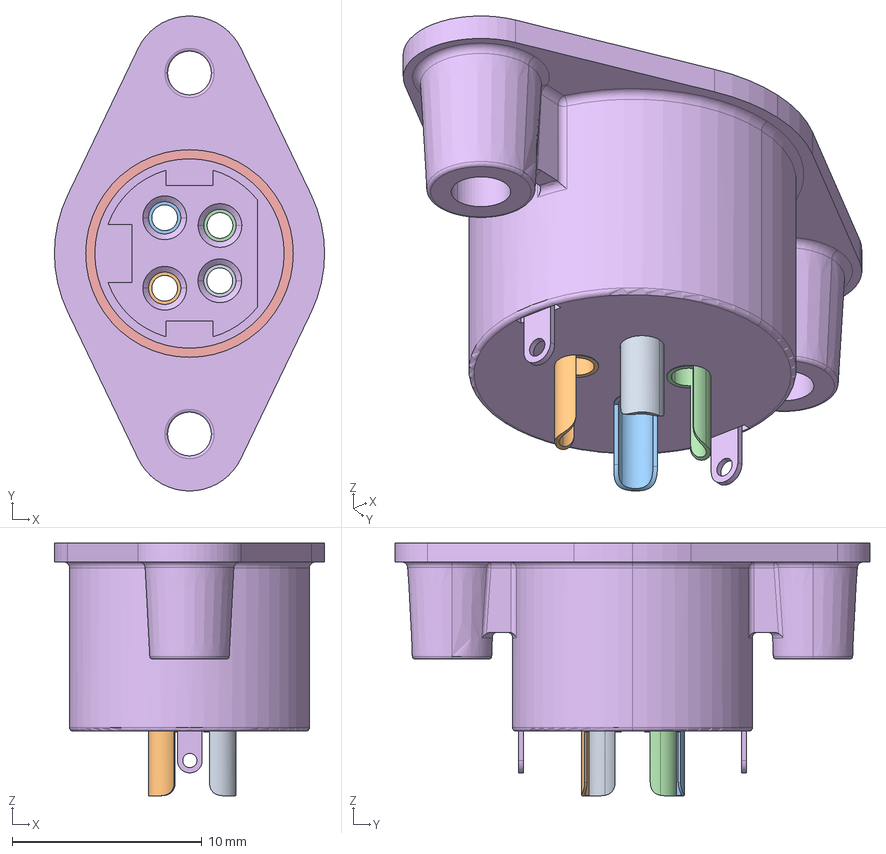
[picture p30: CAD file, 2026-07-16]
external-parts/kpjx-pm-4s-power-connector.FCStd
14.2 x 25.0 x 13.3 mm
KPJX-PM-4S
KPJX-PM-4S001
KPJX-PM-4S002
KPJX-PM-4S003
KPJX-PM-4S004
KPJX-PM-4S005
