Robert-Kurczak/automated-tip-coater-model/heater-module/heater-module-cap.FCStd

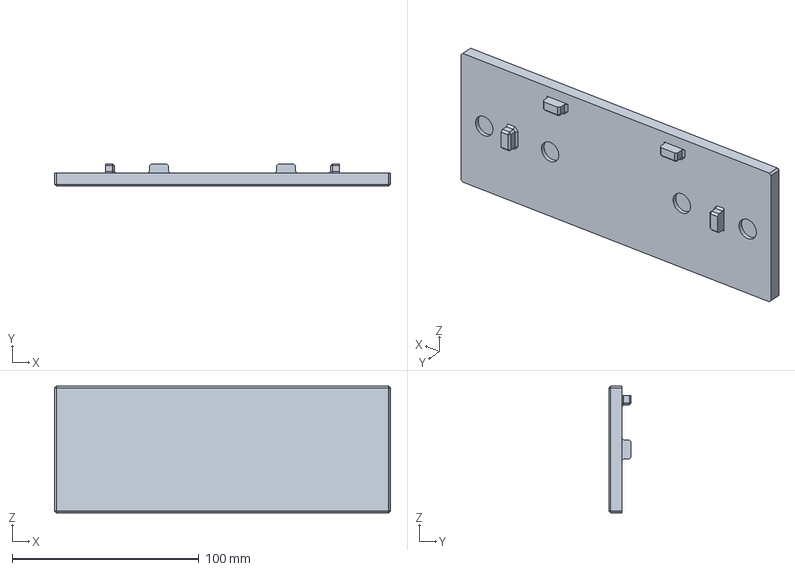
[picture p31: CAD file, 2026-07-16]
heater-module/heater-module-cap.FCStd
180.0 x 12.0 x 68.0 mm
