Robert-Kurczak/automated-tip-coater-model/rotation-module/rotation-module-mounting-bracket.FCStd

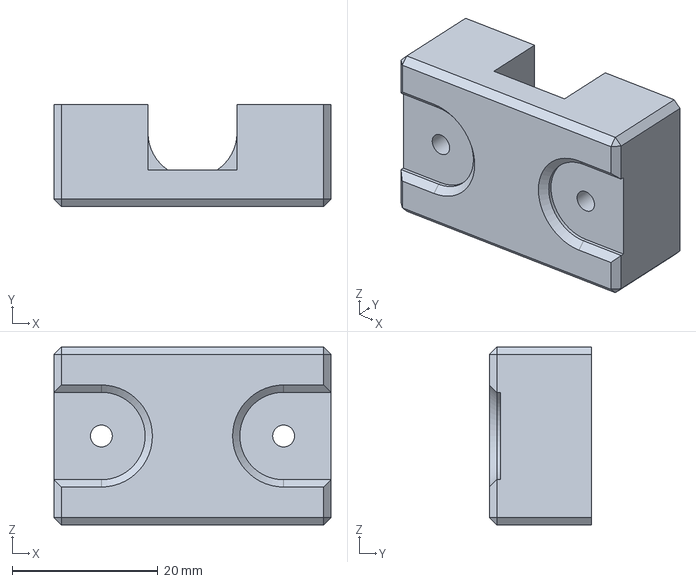
[picture p32: CAD file, 2026-06-24]
rotation-module/rotation-module-mounting-bracket.FCStd
38.0 x 14.0 x 24.4 mm
