Robert-Kurczak/automated-tip-coater-model/x-axis/x-axis-carriage-cap.FCStd

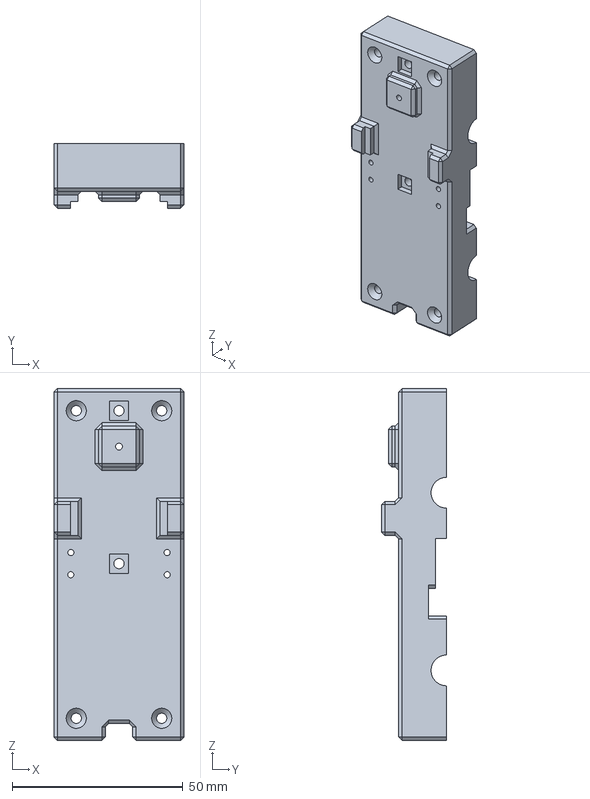
[picture p33: CAD file, 2026-07-16]
x-axis/x-axis-carriage-cap.FCStd
38.0 x 19.0 x 103.0 mm
