Robert-Kurczak/automated-tip-coater-model/z-axis/z-axis-carriage-bearing-cap.FCStd

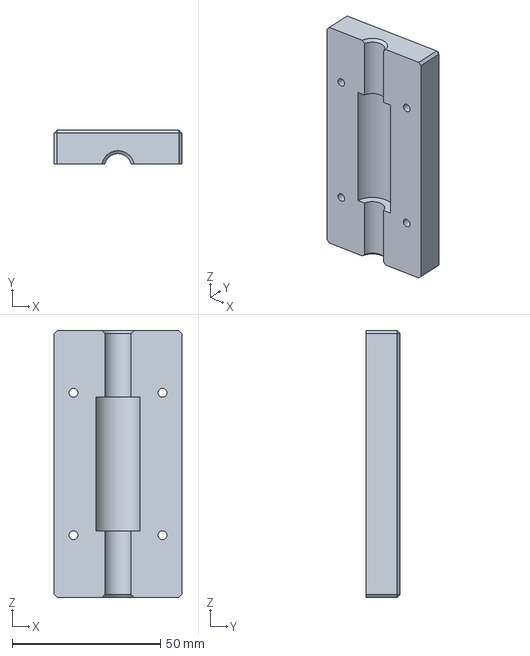
[picture p34: CAD file, 2026-06-24]
z-axis/z-axis-carriage-bearing-cap.FCStd
43.0 x 11.5 x 90.0 mm
