Robert-Kurczak/automated-tip-coater-model/external-parts/axis-connector.FCStd

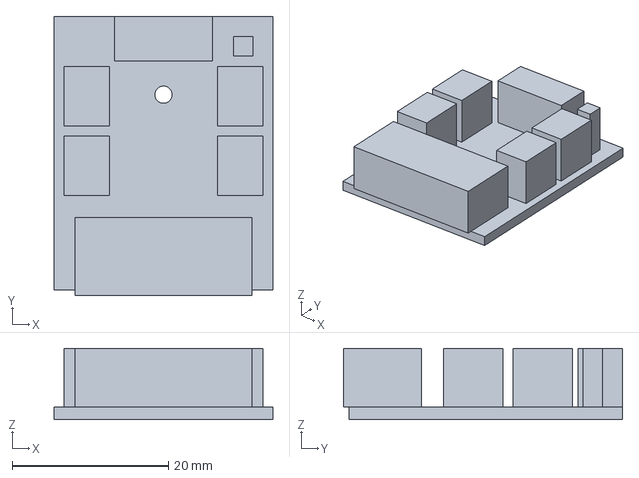
[picture p35: CAD file, 2026-07-16]
external-parts/axis-connector.FCStd
28.0 x 35.7 x 9.10 mm
