Robert-Kurczak/automated-tip-coater-model/heater-module/heater-module-lw980-heater-tray.FCStd

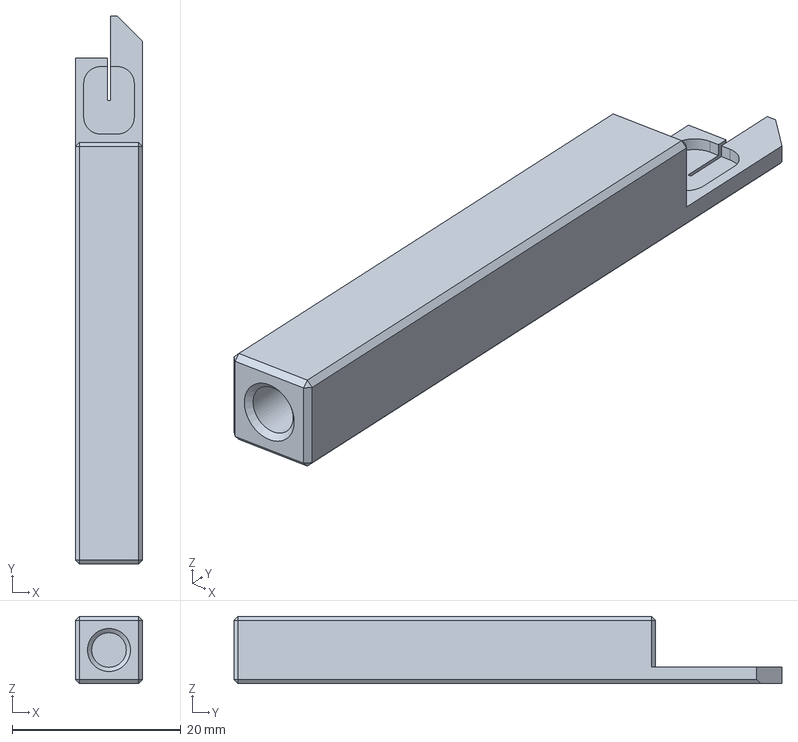
[picture p36: CAD file, 2026-07-16]
heater-module/heater-module-lw980-heater-tray.FCStd
8.00 x 65.0 x 8.00 mm
