Robert-Kurczak/automated-tip-coater-model/x-axis/x-axis-carriage.FCStd

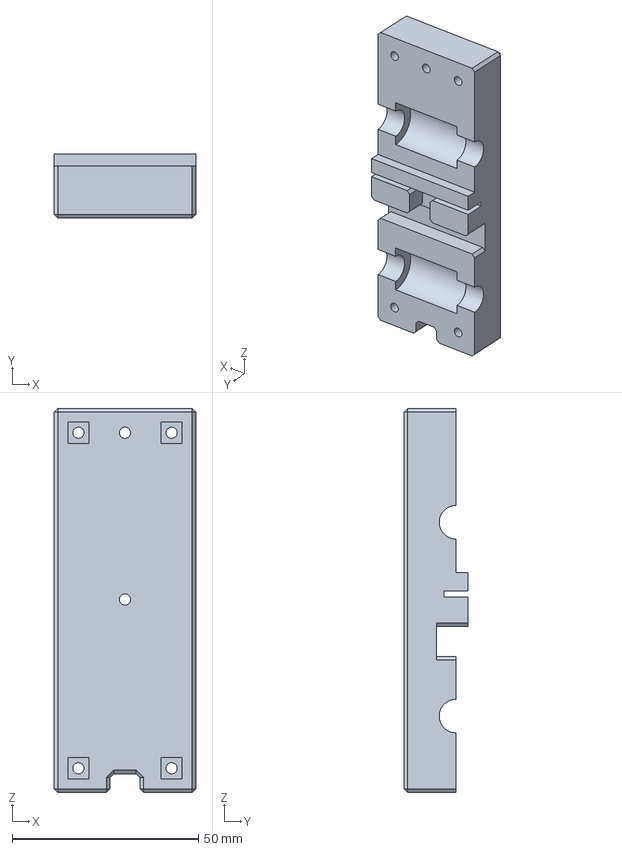
[picture p37: CAD file, 2026-07-16]
x-axis/x-axis-carriage.FCStd
38.0 x 17.3 x 103.0 mm
