Robert-Kurczak/automated-tip-coater-model/z-axis/z-axis-8mm-linear-shaft.FCStd

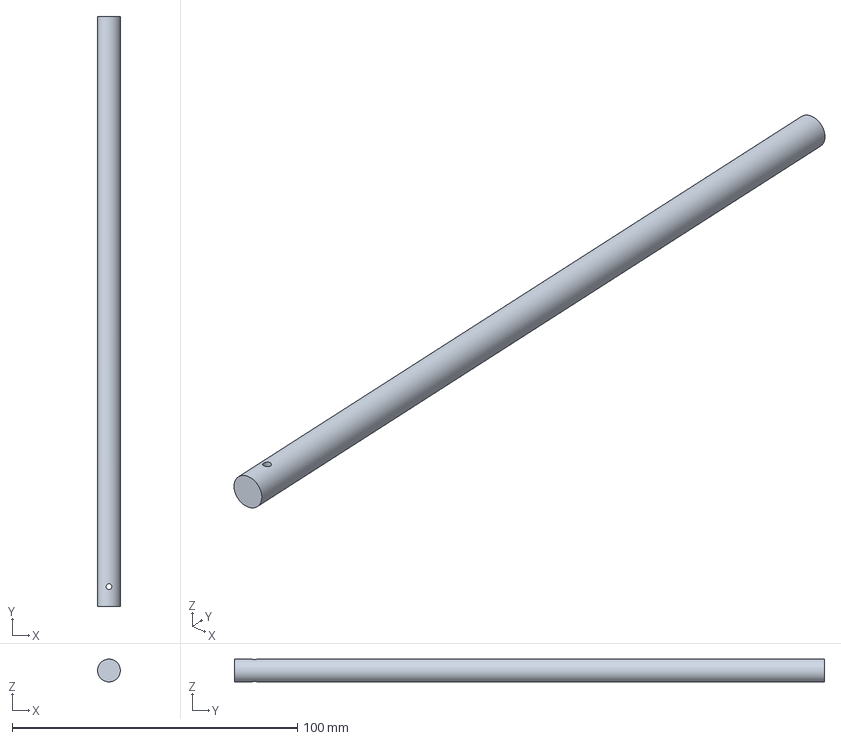
[picture p38: CAD file, 2026-06-24]
z-axis/z-axis-8mm-linear-shaft.FCStd
7.99 x 207.0 x 8.00 mm
