Robert-Kurczak/automated-tip-coater-model/external-parts/rocker-switch-20mm.FCStd

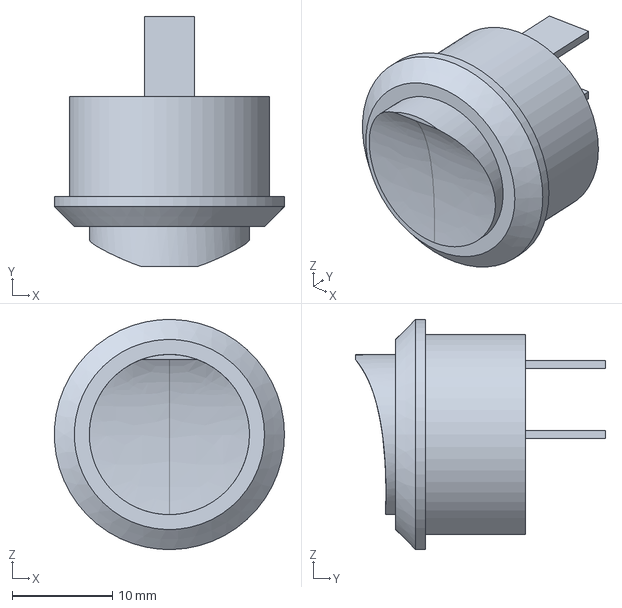
[picture p39: CAD file, 2026-07-16]
external-parts/rocker-switch-20mm.FCStd
23.0 x 25.0 x 23.0 mm
