Robert-Kurczak/automated-tip-coater-model/heater-module/heater-module-hotend-tray.FCStd

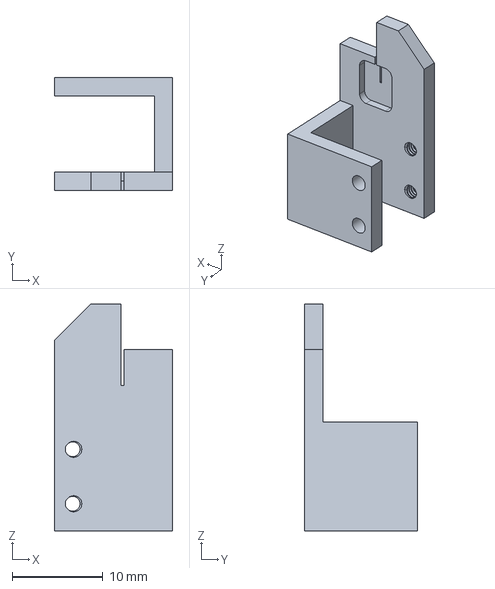
[picture p40: CAD file, 2026-07-16]
heater-module/heater-module-hotend-tray.FCStd
13.0 x 12.4 x 25.0 mm
