Robert-Kurczak/automated-tip-coater-model/x-axis/x-axis-motor-mounting.FCStd

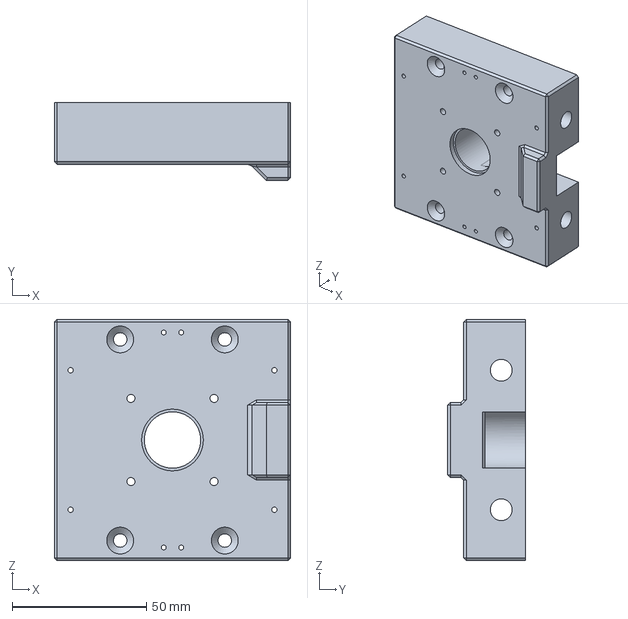
[picture p41: CAD file, 2026-07-16]
x-axis/x-axis-motor-mounting.FCStd
88.0 x 29.0 x 90.0 mm
