Robert-Kurczak/automated-tip-coater-model/external-parts/17hs8401-stepper-motor.FCStd

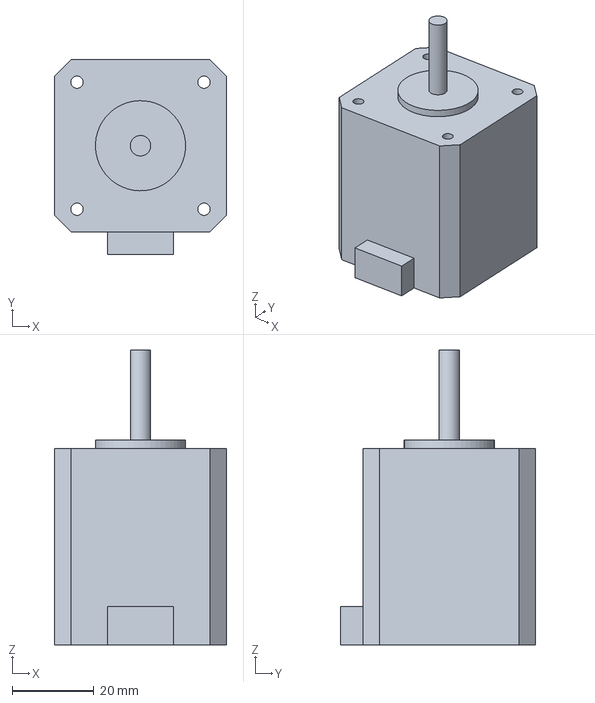
[picture p42: CAD file, 2026-06-24]
external-parts/17hs8401-stepper-motor.FCStd
42.0 x 47.5 x 72.0 mm
