Robert-Kurczak/automated-tip-coater-model/x-axis/x-axis-motor-backplate.FCStd

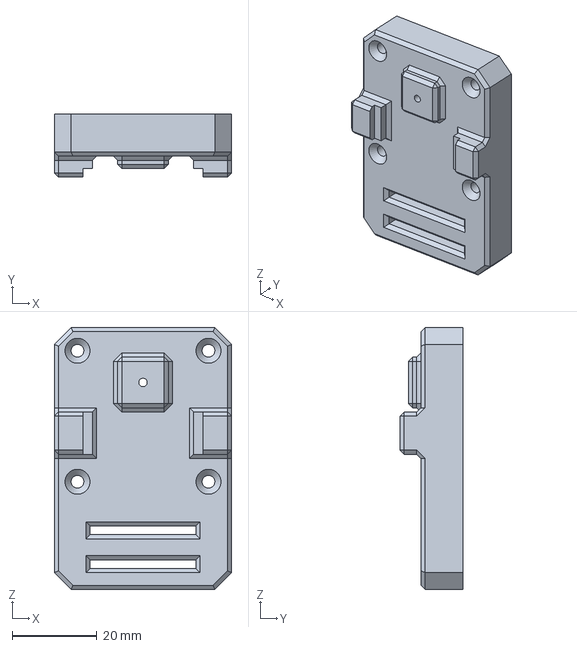
[picture p43: CAD file, 2026-07-16]
x-axis/x-axis-motor-backplate.FCStd
42.0 x 15.0 x 62.0 mm
