Robert-Kurczak/automated-tip-coater-model/external-parts/17hs4023-stepper-motor.FCStd

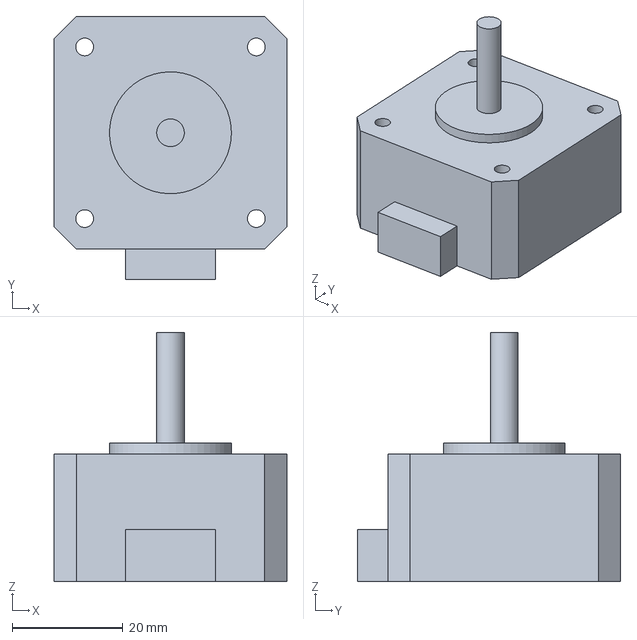
[picture p44: CAD file, 2026-06-24]
external-parts/17hs4023-stepper-motor.FCStd
42.0 x 47.5 x 45.0 mm
