Robert-Kurczak/automated-tip-coater-model/heater-module/heater-module-tray-carriage-cap.FCStd

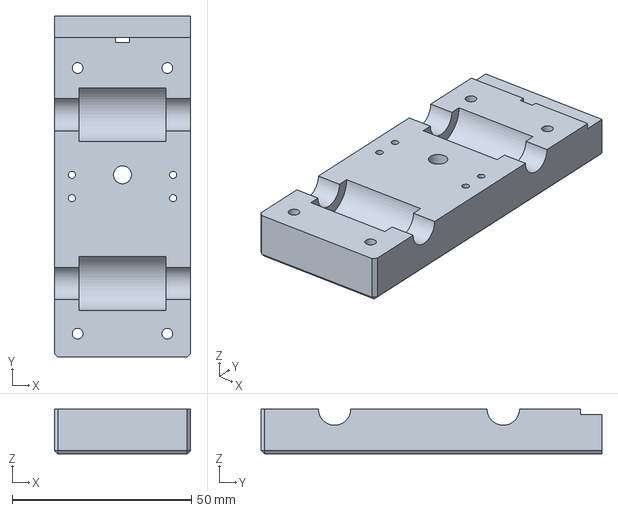
[picture p45: CAD file, 2026-07-16]
heater-module/heater-module-tray-carriage-cap.FCStd
38.0 x 95.0 x 12.5 mm
