Robert-Kurczak/automated-tip-coater-model/external-parts/pololu-3042-dc-motor.FCStd

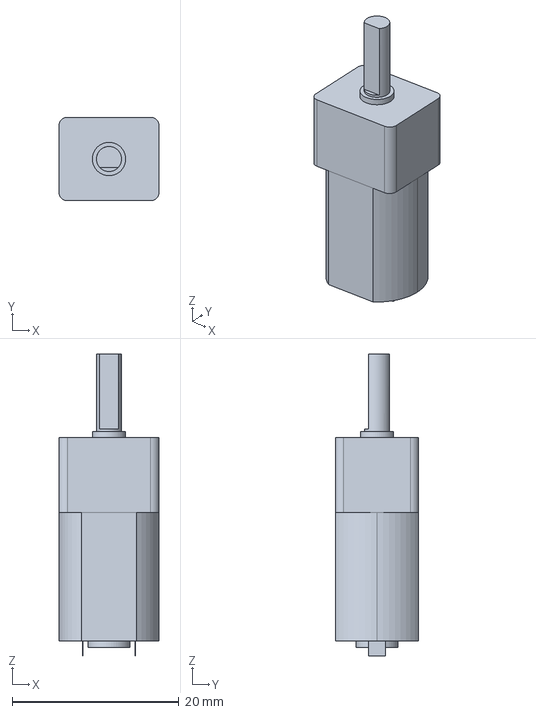
[picture p46: CAD file, 2026-06-24]
external-parts/pololu-3042-dc-motor.FCStd
12.0 x 10.0 x 36.2 mm
