Robert-Kurczak/automated-tip-coater-model/heater-module/heater-module-tray-carriage.FCStd

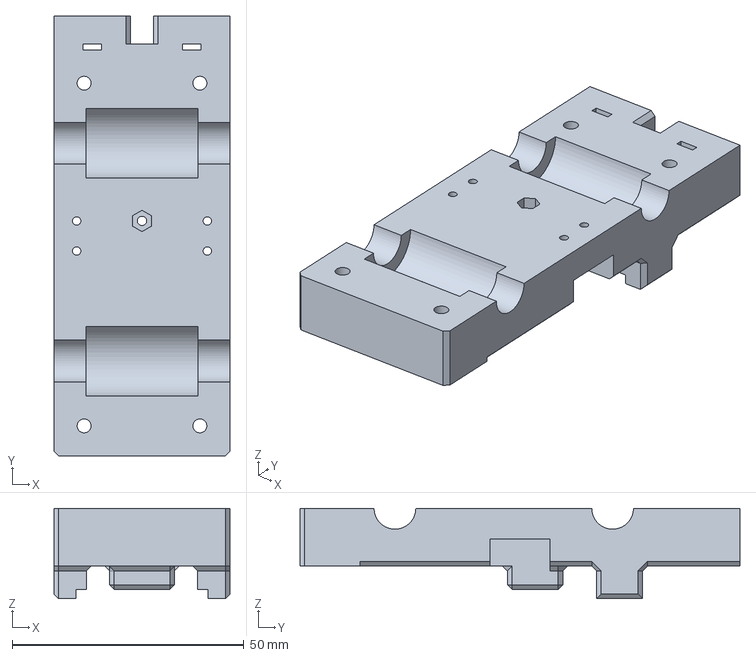
[picture p47: CAD file, 2026-07-16]
heater-module/heater-module-tray-carriage.FCStd
38.0 x 95.0 x 19.5 mm
