Robert-Kurczak/automated-tip-coater-model/external-parts/5x8mm-flexible-coupler.FCStd

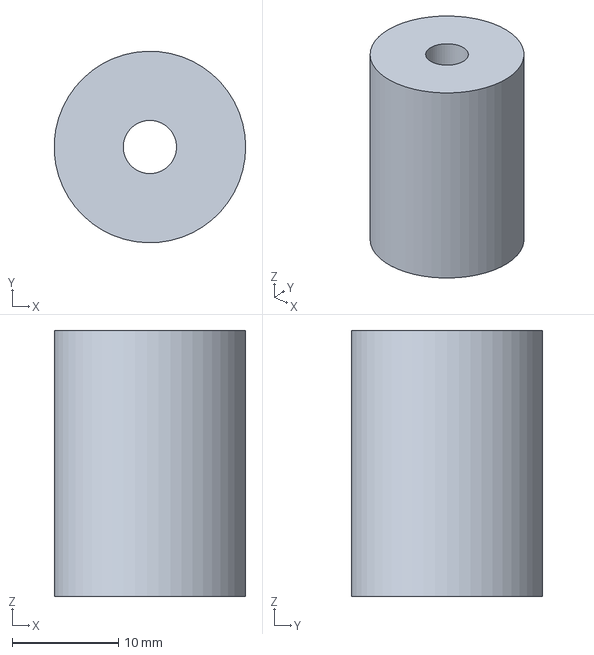
[picture p48: CAD file, 2026-06-24]
external-parts/5x8mm-flexible-coupler.FCStd
18.0 x 18.0 x 25.0 mm
