Robert-Kurczak/automated-tip-coater-model/heater-module/heater-module-base.FCStd

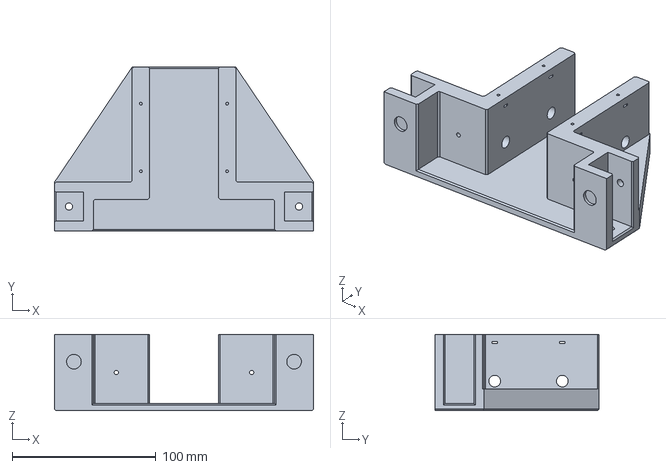
[picture p49: CAD file, 2026-06-24]
heater-module/heater-module-base.FCStd
180.0 x 114.0 x 53.0 mm
