Robert-Kurczak/automated-tip-coater-model/external-parts/gt2-20t-5mm-driver-pulley.FCStd

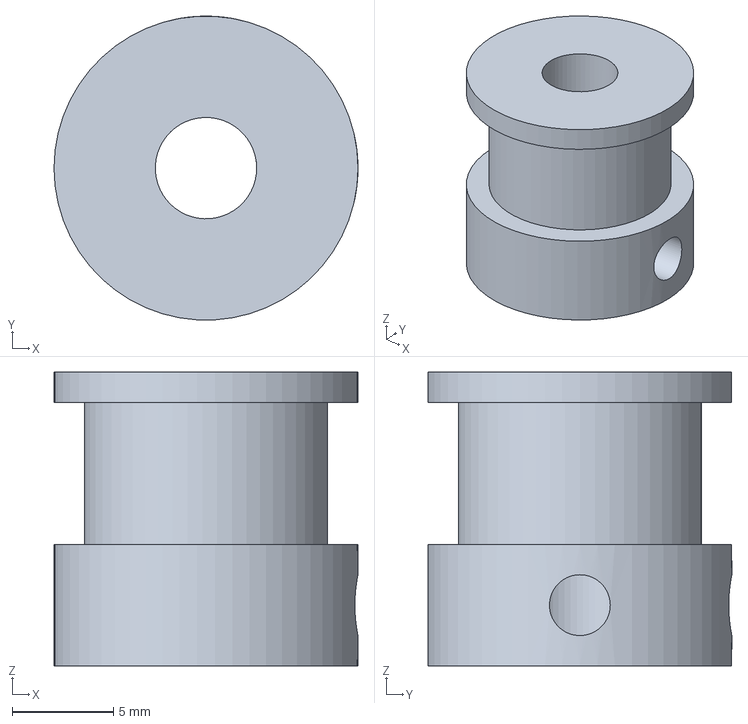
[picture p50: CAD file, 2026-06-24]
external-parts/gt2-20t-5mm-driver-pulley.FCStd
15.0 x 15.0 x 14.5 mm
