Robert-Kurczak/automated-tip-coater-model/heater-module/heater-module-tray-cap.FCStd

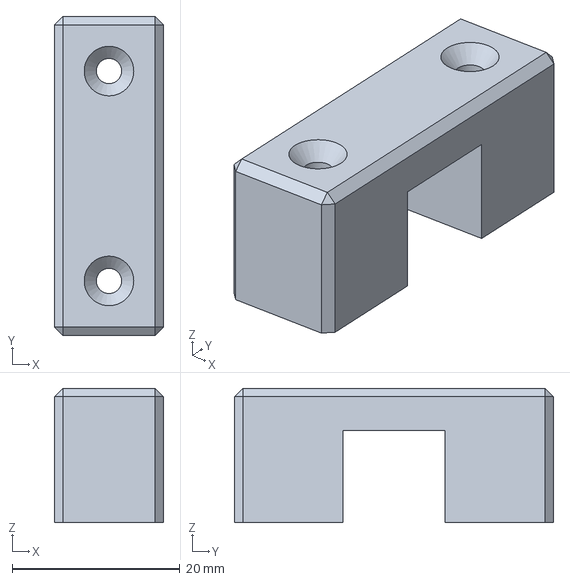
[picture p51: CAD file, 2026-06-24]
heater-module/heater-module-tray-cap.FCStd
13.0 x 38.0 x 16.0 mm
