Robert-Kurczak/automated-tip-coater-model/external-parts/v-slot-l-bracket-triple.FCStd

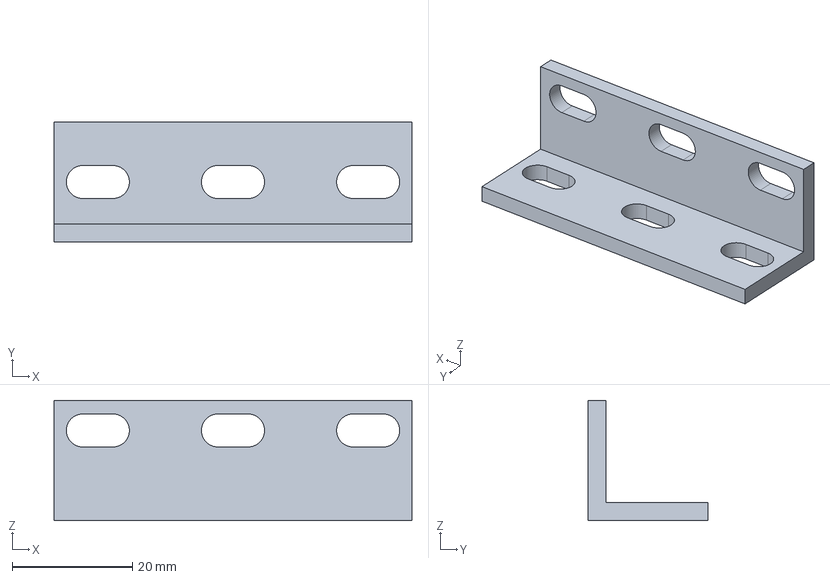
[picture p52: CAD file, 2026-06-24]
external-parts/v-slot-l-bracket-triple.FCStd
59.6 x 20.0 x 20.0 mm
