Robert-Kurczak/automated-tip-coater-model/heater-module/heater-module-tray-carriage-belt-cap.FCStd

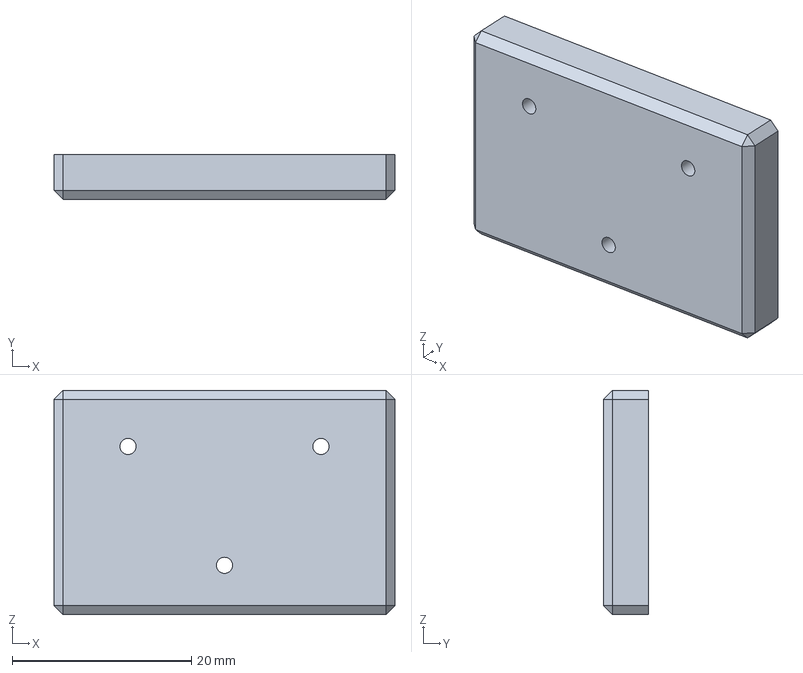
[picture p53: CAD file, 2026-06-24]
heater-module/heater-module-tray-carriage-belt-cap.FCStd
38.0 x 5.00 x 25.0 mm
