Robert-Kurczak/automated-tip-coater-model/external-parts/gt2-20t-5mm-idle-pulley.FCStd

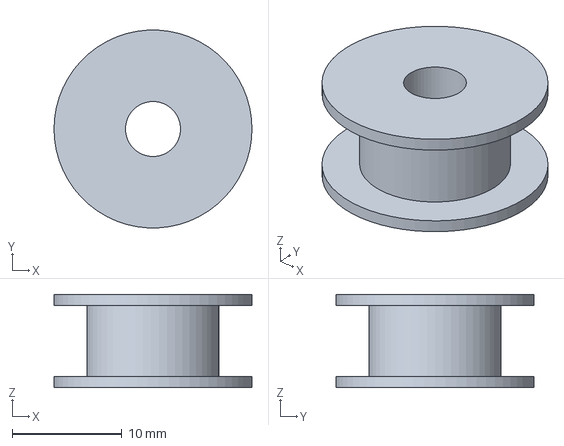
[picture p54: CAD file, 2026-06-24]
external-parts/gt2-20t-5mm-idle-pulley.FCStd
18.0 x 18.0 x 8.50 mm
