Robert-Kurczak/automated-tip-coater-model/heater-module/heater-module-8mm-linear-shaft.FCStd

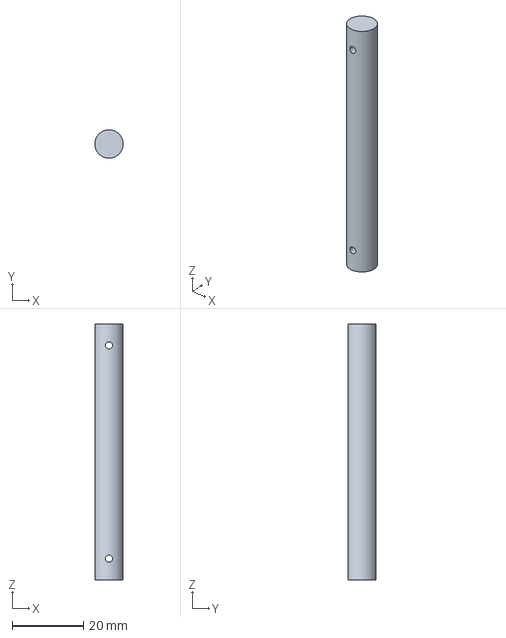
[picture p55: CAD file, 2026-06-24]
heater-module/heater-module-8mm-linear-shaft.FCStd
7.99 x 8.00 x 72.0 mm
