Robert-Kurczak/automated-tip-coater-model/external-parts/lm8uu-45mm-linear-bearing.FCStd

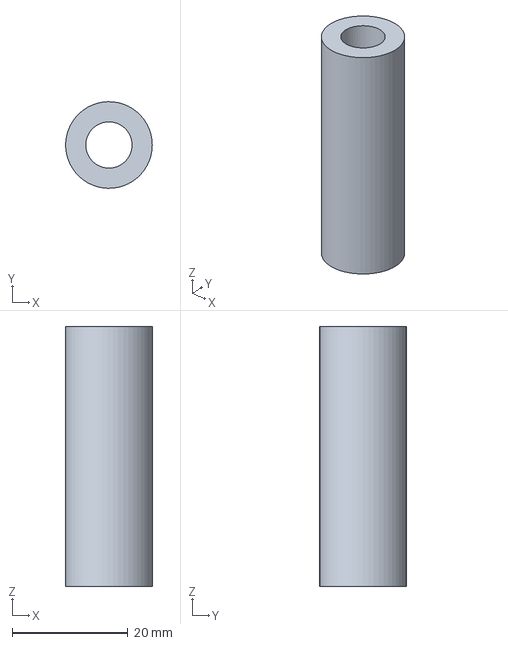
[picture p56: CAD file, 2026-06-24]
external-parts/lm8uu-45mm-linear-bearing.FCStd
15.0 x 15.0 x 45.0 mm
