Robert-Kurczak/automated-tip-coater-model/heater-module/heater-module-gt2-timing-belt.FCStd

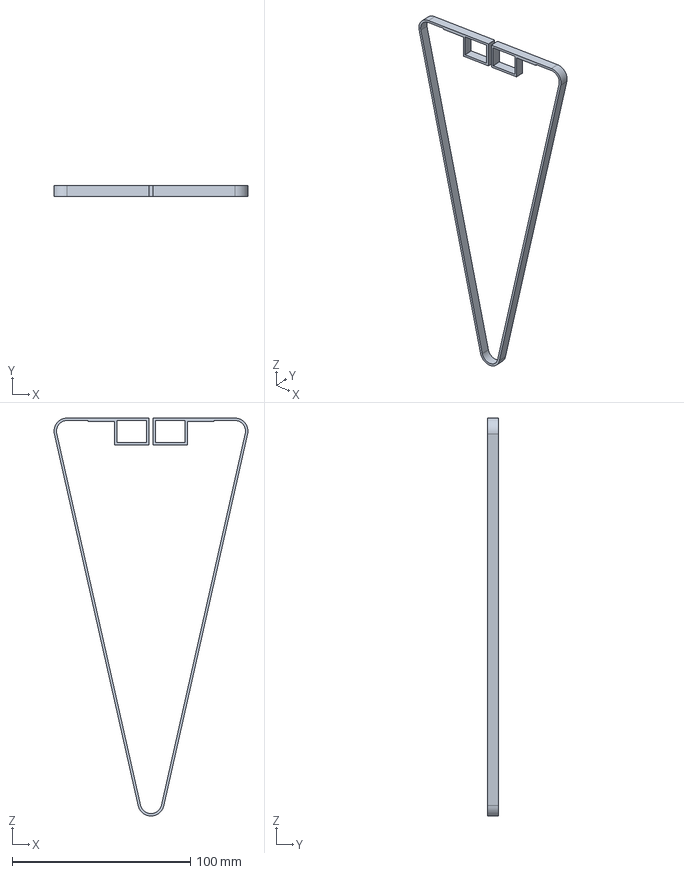
[picture p57: CAD file, 2026-06-24]
heater-module/heater-module-gt2-timing-belt.FCStd
108.8 x 6.00 x 223.3 mm
