Robert-Kurczak/automated-tip-coater-model/external-parts/v-slot-2020x200mm.FCStd

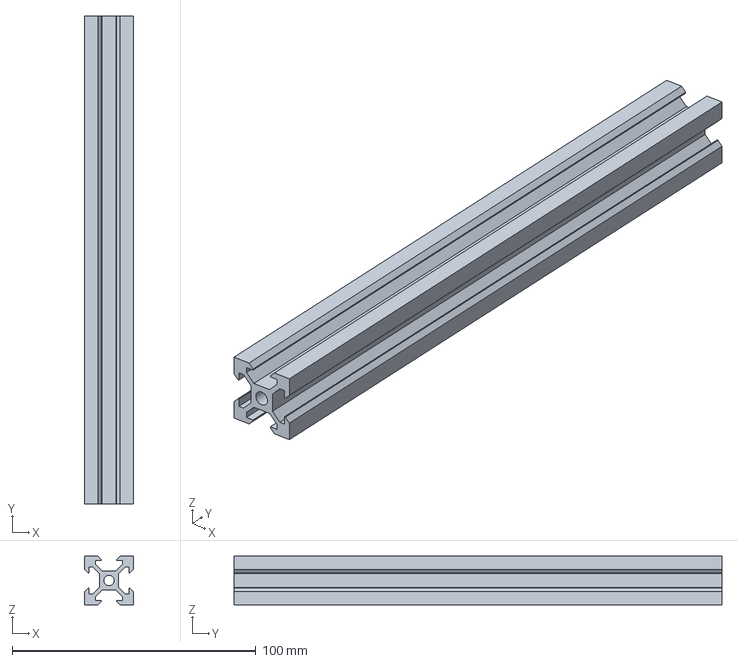
[picture p58: CAD file, 2026-06-24]
external-parts/v-slot-2020x200mm.FCStd
20.0 x 200.0 x 20.0 mm
