Robert-Kurczak/automated-tip-coater-model/external-parts/lw980-ceramic-heater.FCStd

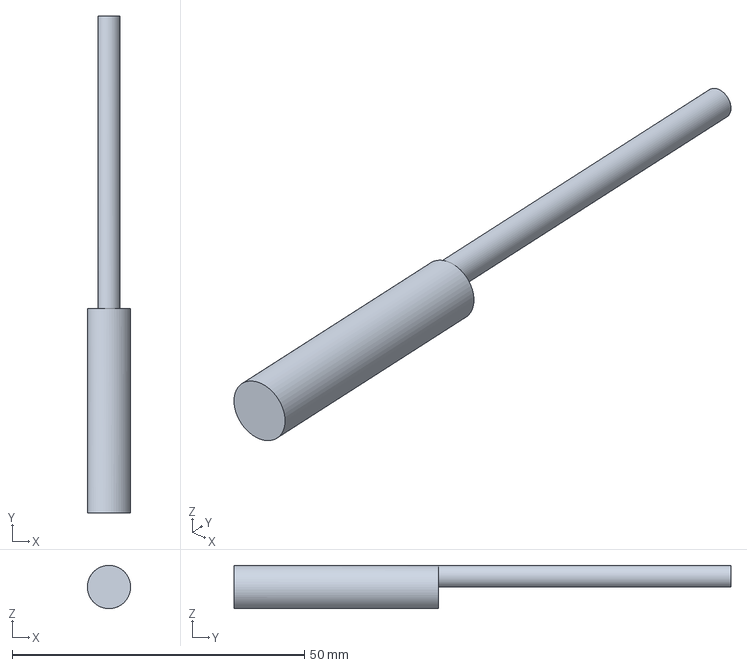
[picture p59: CAD file, 2026-06-24]
external-parts/lw980-ceramic-heater.FCStd
7.40 x 85.0 x 7.40 mm
