Robert-Kurczak/automated-tip-coater-model/external-parts/ceramic-tape-insert-40x2mm.FCStd

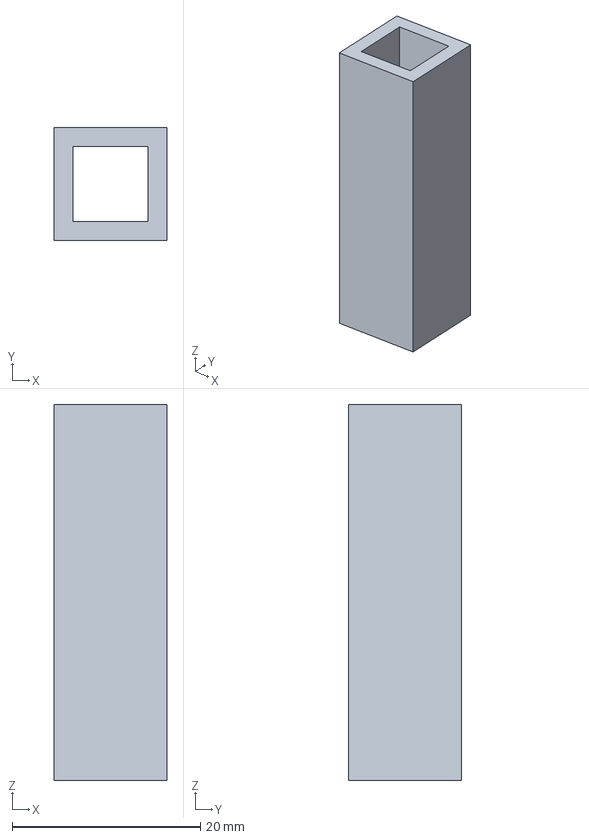
[picture p60: CAD file, 2026-06-24]
external-parts/ceramic-tape-insert-40x2mm.FCStd
12.0 x 12.0 x 40.0 mm
