Robert-Kurczak/automated-tip-coater-model/external-parts/gt2-brass-clip.FCStd

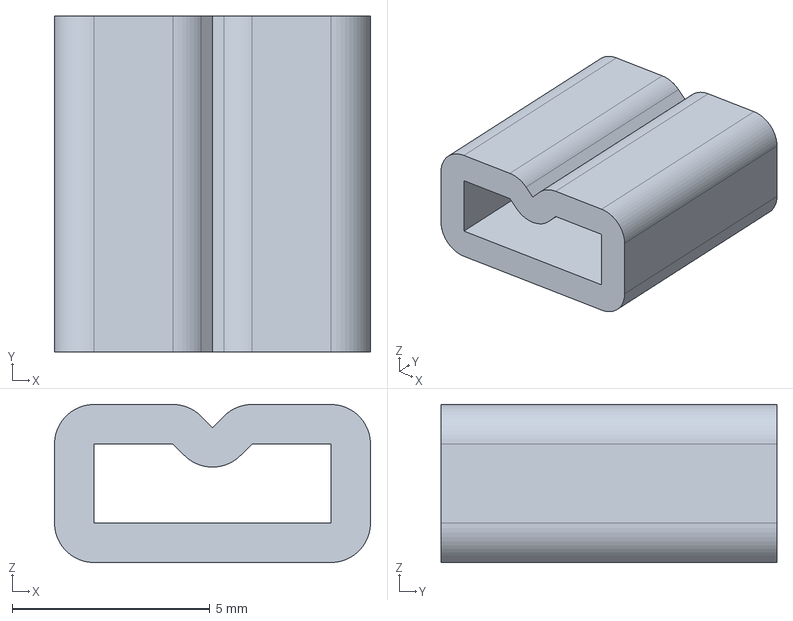
[picture p61: CAD file, 2026-06-24]
external-parts/gt2-brass-clip.FCStd
8.00 x 8.50 x 4.00 mm
