Robert-Kurczak/automated-tip-coater-model/external-parts/10x2mm-magnet.FCStd

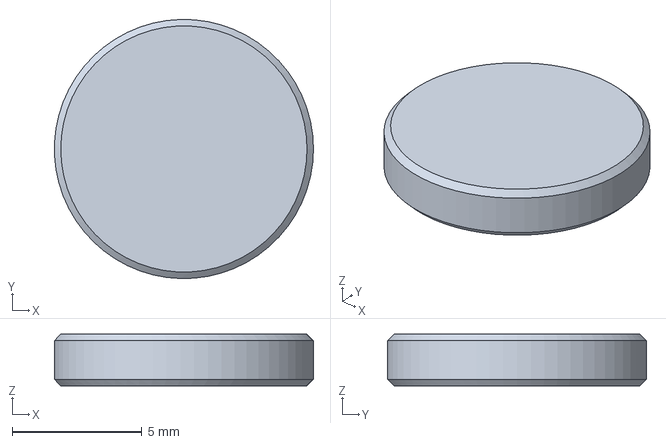
[picture p62: CAD file, 2026-06-24]
external-parts/10x2mm-magnet.FCStd
9.99 x 10.00 x 2.00 mm
