Robert-Kurczak/automated-tip-coater-model/external-parts/lm8uu-linear-bearing.FCStd

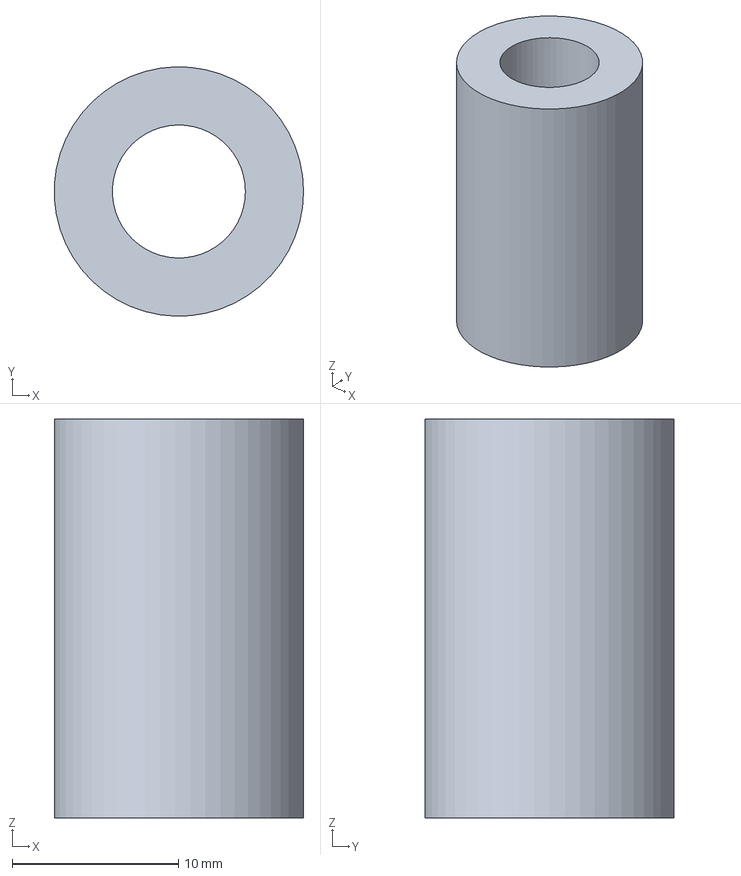
[picture p63: CAD file, 2026-06-24]
external-parts/lm8uu-linear-bearing.FCStd
15.0 x 15.0 x 24.0 mm
