Robert-Kurczak/automated-tip-coater-model/external-parts/v-slot-2060x250mm.FCStd

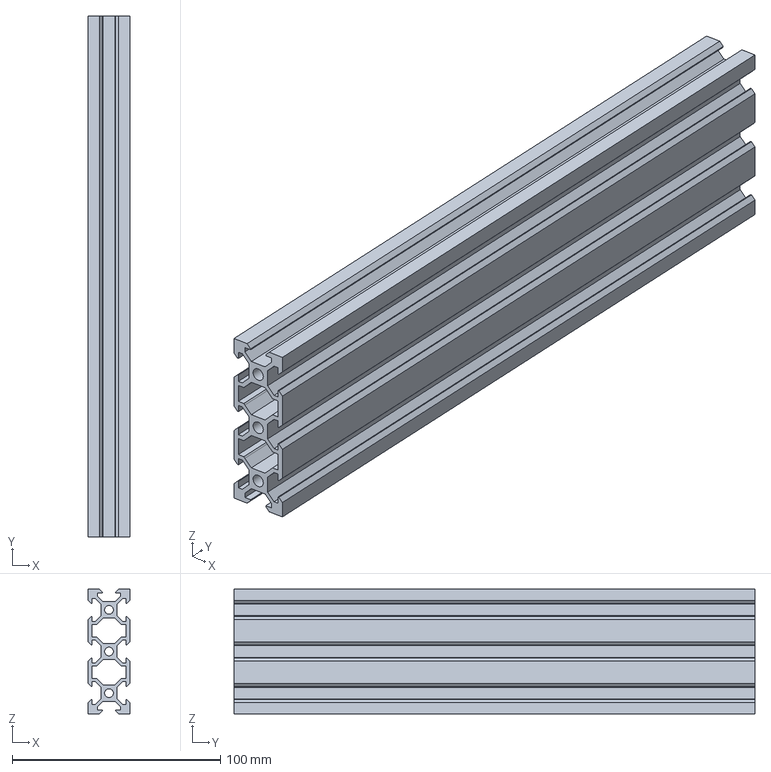
[picture p64: CAD file, 2026-06-24]
external-parts/v-slot-2060x250mm.FCStd
20.0 x 250.0 x 60.0 mm
