Robert-Kurczak/automated-tip-coater-model/external-parts/v-slot-90-deg-bracket.FCStd

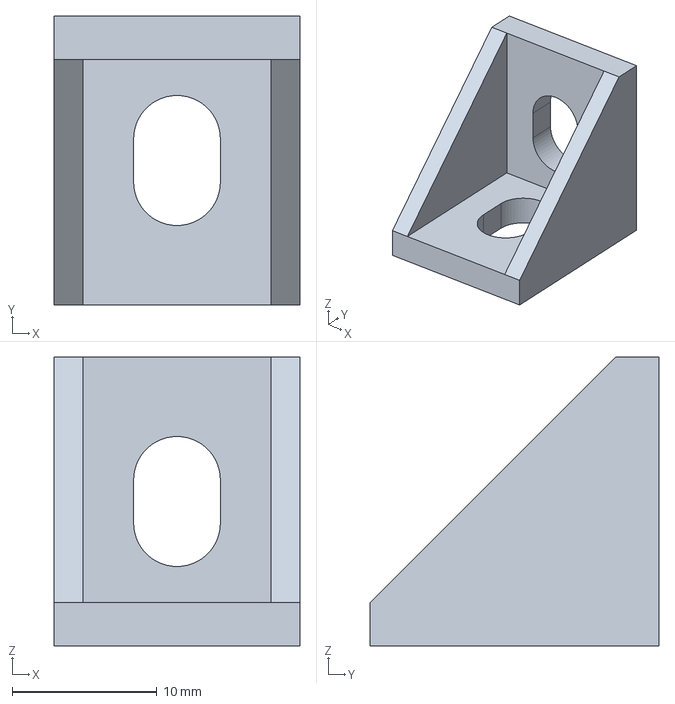
[picture p65: CAD file, 2026-06-24]
external-parts/v-slot-90-deg-bracket.FCStd
17.0 x 20.0 x 20.0 mm
