Robert-Kurczak/automated-tip-coater-model/external-parts/bd-microlance-3-26g-needle.FCStd

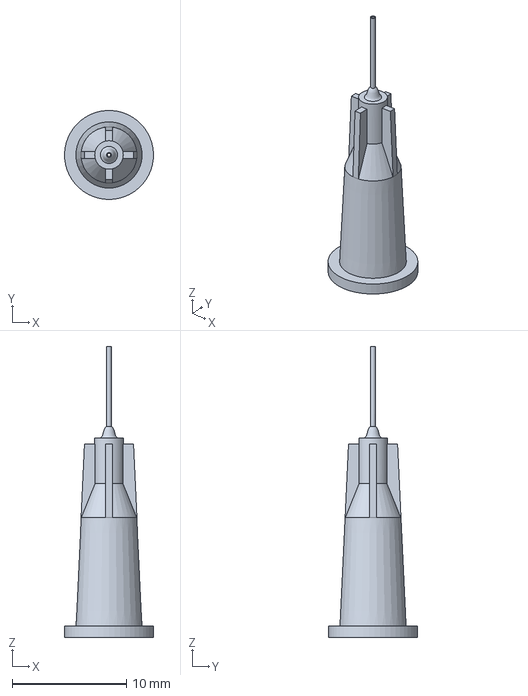
[picture p66: CAD file, 2026-06-24]
external-parts/bd-microlance-3-26g-needle.FCStd
7.80 x 7.79 x 25.5 mm
