Robert-Kurczak/automated-tip-coater-model/(list of files, cad)

Other CAD files:
base/base-right-side.FCStd
external-parts/09403-pogo-pin.FCStd
external-parts/fasteners/m2-hex-nut.FCStd
external-parts/fasteners/m2x14-cap-screw.FCStd
external-parts/fasteners/m2x20-cap-screw.FCStd
external-parts/fasteners/m3-square-nut.FCStd
external-parts/fasteners/m3-washer.FCStd
external-parts/fasteners/m3x20-round-screw.FCStd
external-parts/fasteners/m3x25-countersink-screw.FCStd
external-parts/fasteners/m3x25-round-screw.FCStd
external-parts/fasteners/m3x30-countersink-screw.FCStd
external-parts/fasteners/m3x40-countersink-screw.FCStd
external-parts/fasteners/m5-square-nut.FCStd
external-parts/fasteners/m5x10-countersink-screw.FCStd
external-parts/fasteners/m5x25-round-screw.FCStd
external-parts/fasteners/m5x70-countersink-screw.FCStd
external-parts/fasteners/m5x8-round-screw.FCStd
external-parts/tr8x2-anti-backlash-nut.FCStd
external-parts/v-slot-5mm-t-nut.FCStd
z-axis/z-axis-tr8x2-lead-screw.FCStd
