Robert-Kurczak/automated-tip-coater-model/(commit log)

2024-06-24 Created E3D V6 heat block model
    [e3d-v6-heat-block.FCStd]
2024-06-24 Created initial model for heat block guide
    [heat-block-guide.FCStd]
2024-06-24 Replaced side chamfers with fillets
    [heat-block-guide.FCStd]
2024-06-24 Added chamfers to external edges
    [heat-block-guide.FCStd]
2024-06-24 Adjusted heater module assembly
    [e3d-v6-heat-block-insulation.FCStd, heat-block-guide.FCStd, heater-module-assembly.FCStd]
2024-06-24 Fixed heat block hole position
    [e3d-v6-heat-block.FCStd]
2024-06-24 Created initial isolator tray for E3D V6 heat block
    [e3d-v6-heat-block-tray.FCStd]
2024-06-24 Added new tray for soldering iron heater
    [e3d-v6-heat-block-insulation.FCStd, e3d-v6-heat-block-tray.FCStd, e3d-v6-heat-block.FCStd, heat-block-guide.FCStd, heater-module-assembly.FCStd, lw980-ceramic-heater-tray.FCStd, lw980-ceramic-heater.FCStd]
2024-06-24 Added rack to lw980 heater module guide
    [lw980-ceramic-heater-guide-rack.FCStd, lw980-ceramic-heater-guide.FCStd, lw980-ceramic-heater-tray.FCStd, lw980-heater-module-assembly.FCStd]
2024-06-24 Added chamfers to heater module parts
    [lw980-ceramic-heater-guide-rack.FCStd, lw980-ceramic-heater-guide.FCStd, lw980-ceramic-heater-tray.FCStd, lw980-heater-module-assembly.FCStd]
2024-06-24 Replacing pinion rack with timing belt
    [lw980-ceramic-heater-base.FCStd, lw980-ceramic-heater-guide-rack.FCStd, lw980-ceramic-heater-guide.FCStd, lw980-heater-module-assembly.FCStd]
2024-06-24 Replaced 4mm linear shafts with 8mm
    [ceramic-tape-insert-40x2mm.FCStd, e3d-v6-heat-block-insulation.FCStd, e3d-v6-heat-block-tray.FCStd, e3d-v6-heat-block.FCStd, gt2-5mm-bearing.FCStd, heat-block-guide.FCStd, heater-module-assembly.FCStd, linear-shaft-8x55mm.FCStd]
2024-06-24 Added heater mounting screw hole
    [lw980-ceramic-heater-tray.FCStd, lw980-heater-module-assembly.FCStd]
2024-06-24 Added limit switches to heater module
    [lw980-ceramic-heater-base.FCStd, lw980-heater-module-assembly.FCStd, wk1-01-limit-switch.FCStd]
2024-06-24 Added chamfers to heater module
    [lw980-ceramic-heater-base.FCStd, lw980-ceramic-heater-guide.FCStd, lw980-heater-module-assembly.FCStd, wk1-01-limit-switch.FCStd]
2024-07-10 Added bearings and screw nut mounting
    [x-axis-platform.FCStd]
2024-07-10 Added grooves for bearings secure screws
    [x-axis-platform.FCStd]
2024-07-10 Added better x axis linear bearings mounting
    [x-axis-platform-bearing-lids.FCStd, x-axis-platform.FCStd]
2024-07-10 Added Nema 17 Pancake model
    [17hs4023-stepper-motor.FCStd]
2024-07-10 Created x axis motor and guides mounting
    [x-axis-motor-mounting.FCStd]
2024-07-10 Added gt2 16t pulley
    [gt2-5mm-16t-belt-gear.FCStd]
2024-07-10 Increased x axis platform height for motor mounting
    [x-axis-module-assembly.FCStd, x-axis-motor-mounting.FCStd, x-axis-platform-bearing-lids.FCStd, x-axis-platform.FCStd]
2024-07-10 Aligned x axis shafts with belt
    [17hs4023-stepper-motor.FCStd, gt2-5mm-16t-belt-gear.FCStd, linear-shaft-8x200mm.FCStd, x-axis-module-assembly.FCStd, x-axis-motor-mounting.FCStd, x-axis-platform.FCStd]
2024-07-10 Added x axis end. Integrated x axis limit switches
    [linear-shaft-8x200mm.FCStd, x-axis-module-assembly.FCStd, x-axis-motor-mounting.FCStd, x-axis-platform-end.FCStd, x-axis-platform.FCStd]
2024-07-10 Extended heater module to match x-axis-platform length
    [gt2-5mm-bearing.FCStd, lw980-ceramic-heater-base.FCStd, lw980-ceramic-heater-guide-lid.FCStd, lw980-ceramic-heater-guide.FCStd, lw980-heater-module-assembly.FCStd, wk1-01-limit-switch.FCStd]
2024-07-10 Assembled x-axis-module. Added chamfers and 8x45mm linear bearing
    [lm8uu-45mm-linear-bearing.FCStd, x-axis-module-assembly.FCStd, x-axis-motor-mounting.FCStd, x-axis-platform-bearing-lids.FCStd, x-axis-platform-end.FCStd, x-axis-platform.FCStd]
2024-07-10 Added tr8x2 anti backlash nut to x axis
    [tr8x2-anti-backlash-nut.FCStd, x-axis-module-assembly.FCStd, x-axis-platform-bearing-lids.FCStd, x-axis-platform.FCStd]
2024-08-20 Added initial z axis module case
    [17hs8401-stepper-motor.FCStd, flexible-coupler-5x8.FCStd, tr8x2x128mm-lead-screw.FCStd, v-slot-2060x250mm.FCStd, z-axis-base-left.FCStd, z-axis-base-right.FCStd, z-axis-base-top.FCStd, z-axis-linear-shaft-8x200mm.FCStd]
2024-08-20 Added mount for z axis shafts
    [tr8x2x128mm-lead-screw.FCStd, tr8x2x216mm-lead-screw.FCStd, z-axis-base-right.FCStd, z-axis-base-shaft-mount.FCStd, z-axis-linear-shaft-8x200mm.FCStd, z-axis-linear-shaft-8x300mm.FCStd]
2024-08-20 Added hole for heater module timing belt. Aligned heater module with motor
    [lw980-ceramic-heater-base.FCStd, lw980-ceramic-heater-guide.FCStd, lw980-heater-module-assembly.FCStd, x-axis-module-assembly.FCStd, x-axis-motor-mounting.FCStd, x-axis-platform.FCStd, z-axis-base-top.FCStd, z-axis-module-assembly.FCStd]
2024-08-20 Added vertical v-slots for heater module mounting
    [v-slot-2020x250mm.FCStd, z-axis-base-left.FCStd, z-axis-base-right.FCStd, z-axis-base-top.FCStd, z-axis-linear-shaft-8x300mm.FCStd]
2024-08-20 Fixed heater-module-guide bearings holes positions
    [lw980-ceramic-heater-base.FCStd, lw980-ceramic-heater-guide.FCStd, lw980-heater-module-assembly.FCStd]
2024-08-20 Reassembled wider z-axis-module
    [tr8x2x216mm-lead-screw.FCStd, z-axis-linear-shaft-8mm.FCStd, z-axis-module-assembly.FCStd, z-axis-tr8x2-lead-screw.FCStd]
2024-08-20 Added L bracket mountings for z axis profiles
    [17hs4023-stepper-motor.FCStd, gt2-5mm-16t-belt-gear.FCStd, lw980-heater-module-assembly.FCStd, v-slot-2060x250mm.FCStd, v-slot-l-bracket-triple.FCStd, z-axis-module-assembly.FCStd]
2024-08-20 Fixed z axis shafts pitch
    [lm8uu-45mm-linear-bearing.FCStd, lw980-ceramic-heater-base.FCStd, x-axis-module-assembly.FCStd, x-axis-platform.FCStd, z-axis-base-top.FCStd, z-axis-module-assembly.FCStd]
2024-08-20 Added ATC assembly
    [automatic-tip-coater-assembly.FCStd]
2024-08-30 Added new heater module guide
    [heater-module-tray-guide-belt-lid.FCStd, heater-module-tray-guide-lid.FCStd, heater-module-tray-guide.FCStd, heater-module-tray-lid.FCStd]
2024-08-30 Added new heater module base
    [heater-module-base.FCStd]
2024-08-30 Added new heater module mounting to z axis
    [heater-module-mounting.FCStd]
2024-08-30 Moved and adjusted heater module linear shaft
    [heater-module-linear-shaft-8mm.FCStd, linear-shaft-8x55mm.FCStd]
2024-08-30 Assembled heater module
    [heater-module-assembly.FCStd, heater-module-base.FCStd, heater-module-mounting.FCStd, heater-module-tray-guide-lid.FCStd, heater-module-tray-guide.FCStd, heater-module-tray-lid.FCStd, lw980-ceramic-heater-base.FCStd, lw980-ceramic-heater-guide-lid.FCStd]
2024-08-30 Adjusted z axis module to new heater module
    [automatic-tip-coater-assembly.FCStd, z-axis-base-shaft-mount.FCStd, z-axis-linear-shaft-8mm.FCStd, z-axis-module-assembly.FCStd, z-axis-tr8x2-lead-screw.FCStd]
2024-08-30 Removed limit switches from x axis module
    [automatic-tip-coater-assembly.FCStd, linear-shaft-8x200mm.FCStd, x-axis-linear-shaft-8mm.FCStd, x-axis-module-assembly.FCStd, x-axis-motor-mounting.FCStd, x-axis-platform-end.FCStd]
2024-09-30 Added dc motor model
    [pololu-3042-dc-motor.FCStd]
2024-09-30 Added needle for mounting tip
    [bd-microlance-3-26g-needle.FCStd]
2024-09-30 Added rotation module
    [rotation-module-assembly.FCStd, rotation-module-motor-mounting-lid.FCStd, rotation-module-motor-mounting.FCStd, rotiation-module-guide-lid.FCStd, rotiation-module-guide.FCStd]
2024-09-30 Fixed heater module model
    [heater-module-assembly.FCStd, heater-module-base.FCStd, heater-module-mounting.FCStd, heater-module-tray-guide-belt-lid.FCStd, heater-module-tray-guide-lid.FCStd, heater-module-tray-guide.FCStd, heater-module-tray-lid.FCStd, lw980-ceramic-heater-tray.FCStd]
2024-09-30 Enlarged rotation module timing belt groove
    [rotation-module-assembly.FCStd, rotiation-module-guide-lid.FCStd, rotiation-module-guide.FCStd]
2024-09-30 Added chamfers to rotation module timing belt groove
    [heater-module-assembly.FCStd, heater-module-tray-guide-lid.FCStd, heater-module-tray-guide.FCStd]
2024-09-30 Added limit switches to rotation module
    [rotation-module-assembly.FCStd, rotation-module-motor-mounting.FCStd, rotiation-module-guide-lid.FCStd, rotiation-module-guide.FCStd]
2024-09-30 Added x axis limit switches stops
    [automatic-tip-coater-assembly.FCStd, heater-module-assembly.FCStd, lw980-ceramic-heater-tray.FCStd, rotation-module-assembly.FCStd, rotation-module-motor-mounting-lid.FCStd, rotation-module-motor-mounting.FCStd, rotiation-module-guide-lid.FCStd, rotiation-module-guide.FCStd]
2024-09-30 Made bd needle model more accurate
    [automatic-tip-coater-assembly.FCStd, bd-microlance-3-26g-needle.FCStd, rotation-module-assembly.FCStd]
2024-09-30 Mounted rotation module higher
    [automatic-tip-coater-assembly.FCStd, rotation-module-assembly.FCStd, rotation-module-motor-mounting.FCStd, rotiation-module-guide-lid.FCStd, rotiation-module-guide.FCStd]
2024-10-02 Removed guide from rotation module
    [rotation-module-assembly.FCStd, rotation-module-motor-mounting-lid.FCStd, rotation-module-motor-mounting.FCStd, rotation-module-mounting-bracket.FCStd, rotation-module-mounting.FCStd, rotiation-module-guide-lid.FCStd, rotiation-module-guide.FCStd]
2024-10-02 Moved rotation module guide to x axis module
    [x-axis-8mm-linear-shaft.FCStd, x-axis-assembly.FCStd, x-axis-carriage-cap.FCStd, x-axis-carriage.FCStd, x-axis-end.FCStd, x-axis-linear-shaft-8mm.FCStd, x-axis-module-assembly.FCStd, x-axis-platform-bearing-lids.FCStd]
2024-10-02 Fixed z axis carriage shafts pitch. Divided base from z axis module
    [z-axis-8mm-linear-shaft.FCStd, z-axis-assembly.FCStd, z-axis-base-left.FCStd, z-axis-base-right.FCStd, z-axis-base-shaft-mount.FCStd, z-axis-base-top.FCStd, z-axis-cariage-bearing-cap.FCStd, z-axis-carriage.FCStd]
2024-10-02 Assembled base as a spearate module
    [base-assembly.FCStd, base-bottom.FCStd, base-left-side.FCStd, base-right-side.FCStd, base-top.FCStd]
2024-10-02 Rebuilded heater module. Added cut for servicing carriage
    [heater-module-8mm-linear-shaft.FCStd, heater-module-assembly.FCStd, heater-module-base.FCStd, heater-module-linear-shaft-8mm.FCStd, heater-module-lw980-heater-tray.FCStd, heater-module-mounting.FCStd, heater-module-tray-cap.FCStd, heater-module-tray-carriage-belt-cap.FCStd]
2024-10-02 Recomputed parts
    [17hs4023-stepper-motor.FCStd, 17hs8401-stepper-motor.FCStd, base-assembly.FCStd, base-bottom.FCStd, base-left-side.FCStd, base-right-side.FCStd, base-top.FCStd, bd-microlance-3-26g-needle.FCStd]
2024-10-02 Reasembled all modules. Fixed heater module mounting
    [automatic-tip-coater-assembly.FCStd, base-assembly.FCStd, heater-module-assembly.FCStd, heater-module-mounting.FCStd, x-axis-assembly.FCStd, z-axis-8mm-linear-shaft.FCStd, z-axis-assembly.FCStd, z-axis-tr8x2-lead-screw.FCStd]
2024-10-02 Matched heater module length with z axis carriage
    [automatic-tip-coater-assembly.FCStd, heater-module-assembly.FCStd, heater-module-base.FCStd, heater-module-mounting.FCStd]
2024-10-02 Removed module postfix from x and z axes
    [automatic-tip-coater-assembly.FCStd, x-axis-8mm-linear-shaft.FCStd, x-axis-assembly.FCStd, x-axis-carriage-cap.FCStd, x-axis-carriage.FCStd, x-axis-end.FCStd, x-axis-motor-mounting.FCStd, z-axis-8mm-linear-shaft.FCStd]
2026-06-24 Added new z carriage model
    [z-axis-carriage-new.FCStd]
2026-06-24 Adjusted x axis motor mounting z axis holes distance
    [x-axis-motor-mounting.FCStd]
2026-06-24 Adjusted z axis carriage bearing cap holes distance. Fixed typo in the name
    [z-axis-cariage-bearing-cap.FCStd, z-axis-carriage-bearing-cap.FCStd]
2026-06-24 Reasembled z axis
    [z-axis-assembly.FCStd, z-axis-carriage-new.FCStd, z-axis-carriage.FCStd]
2026-06-24 Reasembled x-axis
    [x-axis-assembly.FCStd]
2026-06-24 Reasembled full assembly
    [automatic-tip-coater-assembly.FCStd]
2026-06-24 Renamed flexible-coupler
    [5x8mm-flexible-coupler.FCStd, automatic-tip-coater-assembly.FCStd, z-axis-assembly.FCStd]
2026-06-24 Added BOM sheet
    [BOM.ods]
2026-06-24 Reworked heater module for easier timing belt assembly
    [gt2-3mm-bearing.FCStd, heater-module-assembly.FCStd, heater-module-base.FCStd, heater-module-mounting.FCStd, m3-washer.FCStd]
2026-06-24 Reworked heater module by adding screws to assembly
    [10x2mm-magnet.FCStd, gt2-5mm-bearing.FCStd, heater-module-assembly.FCStd, heater-module-base.FCStd, heater-module-cap.FCStd, heater-module-lw980-heater-tray.FCStd, heater-module-mounting.FCStd, heater-module-tray-cap.FCStd]
2026-06-24 Added v-slot profiles to heater module
    [heater-module-assembly.FCStd, v-slot-2020x200mm.FCStd, v-slot-2020x250mm.FCStd, v-slot-5mm-t-nut.FCStd]
2026-06-24 Added heater module timing belt
    [heater-module-assembly.FCStd, heater-module-base.FCStd, heater-module-gt2-timing-belt.FCStd]
2026-06-24 Added brass clips to heater module timing belt
    [gt2-brass-clip.FCStd, heater-module-assembly.FCStd, heater-module-gt2-timing-belt.FCStd]
2026-06-24 Adjusted base to new heater module mounting. Added screws to base
    [base-assembly.FCStd, base-left-side.FCStd, base-right-side.FCStd, base-top.FCStd, heater-module-assembly.FCStd, heater-module-base.FCStd, m3x30-countersink-screw.FCStd, m5x8-round-screw.FCStd]
2026-06-24 Reasembled z axis. Changed m3 mounting screws to m5. Changed screws length
    [m5-square-nut.FCStd, z-axis-8mm-linear-shaft.FCStd, z-axis-assembly.FCStd, z-axis-carriage-bearing-cap.FCStd, z-axis-carriage.FCStd, z-axis-shafts-mounting.FCStd, z-axis-tr8x2-lead-screw.FCStd]
2026-06-24 Increased z axis carriage height for better screw holes clearance
    [z-axis-assembly.FCStd, z-axis-carriage-bearing-cap.FCStd, z-axis-carriage.FCStd]
2026-06-24 Added fasteners and timing belt to x axis assembly. Changed gt2 pulleys to 20t
    [gt2-20t-5mm-driver-pulley.FCStd, gt2-20t-5mm-idle-pulley.FCStd, gt2-3mm-bearing.FCStd, gt2-5mm-16t-belt-gear.FCStd, m5x25-round-screw.FCStd, m5x70-countersink-screw.FCStd, x-axis-assembly.FCStd, x-axis-carriage-cap.FCStd]
2026-06-24 Added screws to rotation module assembly
    [rotation-module-assembly.FCStd]
2026-06-24 Changed idle pulleys models in heater module assembly
    [heater-module-assembly.FCStd]
2026-06-24 Changed heater module driver pulley to 20t
    [base-assembly.FCStd, heater-module-assembly.FCStd, heater-module-gt2-timing-belt.FCStd]
2026-06-24 Parsing part type in BOM macro
2026-06-24 Added additional columns in bom file
    [automatic-tip-coater-assembly-bom.csv]
2026-06-24 Created BOM.ods based on macro outcome
    [10x2mm-magnet.FCStd, 17hs4023-stepper-motor.FCStd, 17hs8401-stepper-motor.FCStd, 5x8mm-flexible-coupler.FCStd, BOM.ods, automatic-tip-coater-assembly-bom.csv, automatic-tip-coater-assembly.FCStd, base-bottom.FCStd]
2026-07-16 Added z axis limit switches
    [automated-tip-coater-assembly-bom.csv, automated-tip-coater-assembly.FCStd, wk1-01-limit-switch.FCStd, x-axis-assembly.FCStd, x-axis-carriage-cap.FCStd, x-axis-carriage.FCStd, x-axis-motor-mounting.FCStd]
2026-07-16 Aligned x axis width with base width. Increased size for gt2 brass clip
    [automated-tip-coater-assembly.FCStd, x-axis-8mm-linear-shaft.FCStd, x-axis-assembly.FCStd, x-axis-end.FCStd, x-axis-gt2-timing-belt.FCStd]
2026-07-16 Fixed heater base z axis pitch
    [automated-tip-coater-assembly.FCStd, heater-module-assembly.FCStd, heater-module-mounting.FCStd, z-axis-assembly.FCStd]
2026-07-16 Fixed base top. Split it to two parts - one for electronics and one for motor
    [automated-tip-coater-assembly.FCStd, base-assembly.FCStd, base-electronics-top.FCStd, base-motor-top.FCStd, base-top-bak.FCStd, base-top.FCStd]
2026-07-16 Added base bottom
    [automated-tip-coater-assembly.FCStd, base-assembly.FCStd, base-bottom.FCStd, base-electronics-top.FCStd, base-top-bak.FCStd]
2026-07-16 Simplified base motor top
    [automated-tip-coater-assembly.FCStd, automatic-tip-coater-assembly-bom.csv, automatic-tip-coater-assembly.FCStd, base-assembly.FCStd, base-electronics-top.FCStd, base-motor-top.FCStd, base-right-side.FCStd]
2026-07-16 Added base side cutout
    [automated-tip-coater-assembly.FCStd, base-assembly.FCStd, base-electronics-top.FCStd, base-left-side.FCStd, kpjx-pm-4s-power-connector.FCStd, rocker-switch-20mm.FCStd]
2026-07-16 Reworked rotation module. Increased spindle height
    [automated-tip-coater-assembly.FCStd, base-electronics-top.FCStd, rotation-module-assembly.FCStd, rotation-module-mounting.FCStd, x-axis-assembly.FCStd, x-axis-carriage.FCStd]
2026-07-16 Added pin slot to rotation module
    [09403-pogo-pin.FCStd, automated-tip-coater-assembly.FCStd, m2x14-cap-screw.FCStd, rotation-module-assembly.FCStd, rotation-module-mounting.FCStd, rotation-module-pin-holder.FCStd]
2026-07-16 Added Bambu FAH003 model
    [bambu-fah003-hotend.FCStd]
2026-07-16 Added fah003 hotend
    [bambu-fah003-hotend.FCStd, heater-module-assembly.FCStd]
2026-07-16 Added bambu hotend to heater module
    [automated-tip-coater-assembly.FCStd, heater-module-assembly.FCStd, heater-module-bambu-hotend-assembly.FCStd, heater-module-custom-tray-assembly.FCStd, heater-module-hotend-cap.FCStd, heater-module-lw980-heater-tray.FCStd, rotation-module-assembly.FCStd, rotation-module-pin-holder.FCStd]
2026-07-16 Added tray for hotend
    [automated-tip-coater-assembly.FCStd, bambu-fah003-hotend.FCStd, heater-module-assembly.FCStd, heater-module-bambu-hotend-assembly.FCStd, heater-module-hotend-tray.FCStd]
2026-07-16 Added display model
    [waveshare-17143-display.FCStd]
2026-07-16 Added display module
    [automated-tip-coater-assembly.FCStd, display-module-assembly.FCStd, display-module-backplate.FCStd, display-module-frontplate.FCStd, m3-square-nut.FCStd, waveshare-17143-display.FCStd]
2026-07-16 Added clearence to display module front plate
    [display-module-assembly.FCStd, display-module-frontplate.FCStd]
2026-07-16 Adjusted display module mounting slots
    [display-module-assembly.FCStd, display-module-backplate.FCStd]
2026-07-16 Added display module mounting
    [automated-tip-coater-assembly.FCStd, display-module-assembly.FCStd, display-module-backplate.FCStd, display-module-frontplate.FCStd, display-module-mounting.FCStd]
2026-07-16 Added cutout for display cable
    [automated-tip-coater-assembly.FCStd, base-assembly.FCStd, base-electronics-top.FCStd]
2026-07-16 Added optional shaft adapter to rotation module
    [NewMotorTipAdapterShaft1_5v0_80.STL, rotation-module-assembly.FCStd, rotation-module-shaft-adapter.FCStd]
2026-07-16 Fixed x axis screw head chamfers
    [automated-tip-coater-assembly.FCStd, x-axis-assembly.FCStd, x-axis-carriage-cap.FCStd]
2026-07-16 Added axis connector to heater module
    [automated-tip-coater-assembly.FCStd, axis-connector.FCStd, heater-module-assembly.FCStd, heater-module-tray-carriage-cap.FCStd, heater-module-tray-carriage.FCStd, m2-hex-nut.FCStd]
2026-07-16 Added magnets to heater module cap
    [heater-module-assembly.FCStd, heater-module-cap.FCStd]
2026-07-16 Added axis connector to x axis
    [NewMotorTipAdapterShaft1_5v0_80.STL, heater-module-tray-carriage.FCStd, x-axis-assembly.FCStd, x-axis-carriage-cap.FCStd, x-axis-carriage.FCStd, x-axis-motor-backplate.FCStd]
2026-07-16 Added base cutout for wires
    [automated-tip-coater-assembly.FCStd, base-assembly.FCStd, base-motor-top.FCStd, x-axis-assembly.FCStd, x-axis-carriage-cap.FCStd, x-axis-carriage.FCStd]
